jdionaldo/sc-trike/ws02/blueprint_shell/flat_P2L.png

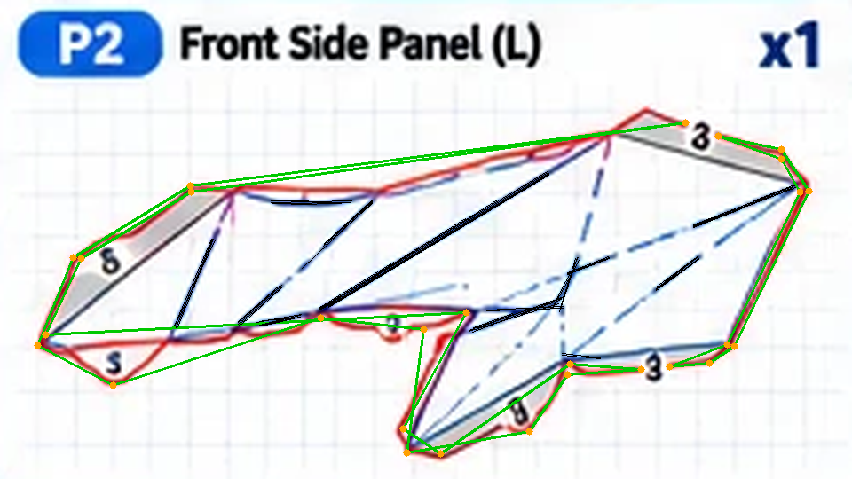
ws02/blueprint_shell/flat_P2L.png
