jdionaldo/sc-trike/ws02/blueprint_shell/flat_P8L.png

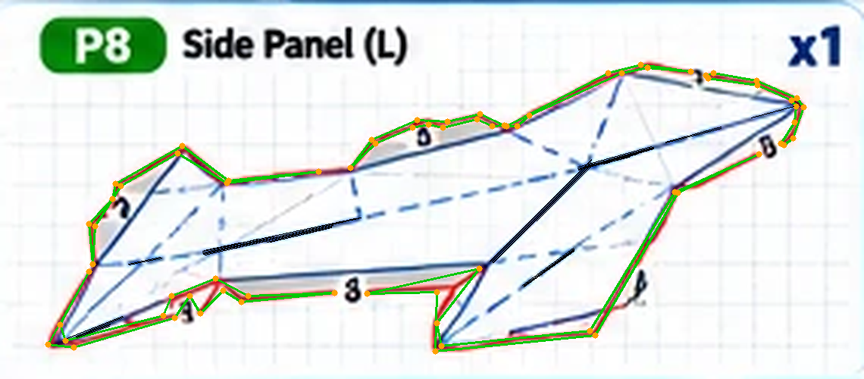
ws02/blueprint_shell/flat_P8L.png
