jdionaldo/sc-trike/ws02/WS03_REPORT.md

# WS-03 report (3WD lean-steer reverse trike)

Generated by `w3_report.py`. Mass is volume x 1.27 g/cc (solid; real prints are lighter with infill).

| part | size mm | volume cm3 | mass g |
|---|---|---|---|
| w3_arm_left | 128.0 x 31.5 x 9.5 | 17.6 | 22 |
| w3_arm_cover_left | 128.0 x 19.0 x 1.5 | 3.6 | 5 |
| w3_uplink_left | 114.0 x 10.0 x 3.5 | 3.9 | 5 |
| w3_carrier_left | 20.0 x 52.0 x 32.0 | 10.6 | 14 |
| w3_knuckle_left | 22.0 x 42.5 x 26.0 | 9.5 | 12 |
| w3_arm_right | 128.0 x 31.5 x 9.5 | 17.6 | 22 |
| w3_arm_cover_right | 128.0 x 19.0 x 1.5 | 3.6 | 5 |
| w3_uplink_right | 114.0 x 10.0 x 3.5 | 3.9 | 5 |
| w3_carrier_right | 20.0 x 52.0 x 32.0 | 10.6 | 14 |
| w3_knuckle_right | 22.0 x 42.5 x 26.0 | 9.5 | 12 |
| w3_tie_rod x2 | 119.8 x 10.4 x 5.2 | 4.3 | 11 |
| w3_lean_rod x2 | 40.4 x 10.4 x 5.2 | 1.5 | 4 |
| w3_fdc_lower | 78.0 x 80.5 x 22.0 | 88.6 | 113 |
| w3_fdc_upper | 78.0 x 60.0 x 22.0 | 77.7 | 99 |
| w3_cdc_lower | 47.0 x 52.0 x 22.0 | 29.4 | 37 |
| w3_cdc_upper | 47.0 x 52.0 x 22.0 | 28.8 | 37 |
| w3_rbc_lower | 53.0 x 30.0 x 21.0 | 24.5 | 31 |
| w3_rbc_upper | 53.0 x 30.0 x 21.0 | 24.5 | 31 |
| w3_motor_plate | 45.0 x 38.0 x 4.0 | 6.4 | 8 |
| w3_rear_arm | 116.6 x 22.0 x 12.0 | 20.6 | 26 |
| w3_rear_arm_cover | 116.6 x 22.0 x 1.5 | 3.8 | 5 |
| w3_batt_tray | 66.0 x 24.0 x 16.0 | 8.4 | 11 |
| w3_esc_tray | 50.0 x 42.0 x 16.0 | 8.9 | 11 |
| w3_uplink_standoff | 8.0 x 8.0 x 6.8 | 0.3 | 0 |
| w3_body_post x2 | 7.6 x 7.6 x 50.0 | 2.0 | 5 |
| w3_wing_left | 90.0 x 44.0 x 3.0 | 8.5 | 11 |
| w3_wing_right | 90.0 x 44.0 x 3.0 | 8.5 | 11 |
| w3_skid | 47.0 x 80.0 x 3.0 | 9.4 | 12 |
| w3_deck_front | 169.0 x 66.0 x 3.0 | 31.1 | 40 |
| w3_deck_rear | 143.0 x 120.0 x 3.0 | 43.9 | 56 |
| w3_wall_left | 120.0 x 72.0 x 3.0 | 20.8 | 26 |
| w3_wall_right | 120.0 x 72.0 x 3.0 | 20.8 | 26 |
| lid3 | 55.5 x 47.5 x 17.3 | 6.7 | 8 |
| body3_left_front | 182.6 x 71.0 x 104.3 | 36.4 | 46 |
| body3_left_rear | 212.9 x 71.0 x 136.2 | 75.2 | 95 |
| body3_right_front | 182.6 x 71.0 x 104.3 | 36.4 | 46 |
| body3_right_rear | 212.9 x 71.0 x 136.2 | 76.8 | 98 |

Printed total (solid, one set; left/right pairs listed separately): about 1019 g.

## Design numbers

- Front track 269 mm (wheel centres), wheelbase 360 mm, front tires 83 x 24, rear 112 x 62.
- Lean limit 25 deg, arm length 100 mm, arm swing about 40 deg, steering +-17 deg (radio mix), 4 servos (lean and steer per front wheel).
- Chassis raked 4 deg nose-down; shaft line at the front axle height, y +21.
- Gearing: motor 15T to centre diff ring 45T (3:1), bevel 12T/30T (2.5:1) at both ends, front belt 20T to 16T, rear belt 20T to 22T.
- Pose sweep: lean -25..+25 with steer 0, +17, -17: no interference (tests/test_w3.py).
