jdionaldo/sc-trike/ws02/WS03_CLEARANCE.md

# WS-03 clearance check

Poses: lean/steer [(0.0, 0.0), (20.0, 17.0), (-20.0, -17.0)]. Pairs closer than 0.3 mm that are not declared as mated:

- mock_cdiff_ring / w3_cring_hub: 0.00 mm
- w3_rring_hub / b_rear_ring: 0.01 mm
- battery_tray_c / b_battery: 0.01 mm
- w3_motor_plate / b_motor: 0.01 mm
- lean_mount_c / lean_horn_c: 0.01 mm
- mock_cdiff_carrier / w3_cring_hub: 0.01 mm
- w3_pillow_lower / w3_pillow_upper: 0.01 mm
- lean_mount_c / lean_ears_c: 0.01 mm
- w3_fdc_lower / w3_fdc_upper: 0.02 mm
- w3_cdc_lower / w3_cdc_upper: 0.02 mm
- w3_frame_front / w3_uplink_standoff_-1: 0.02 mm
- w3_frame_front / w3_uplink_standoff_1: 0.02 mm
- w3_rbc_lower / w3_rbc_upper: 0.02 mm
- w3_deck_rear / w3_deck_tail: 0.03 mm
- w3_deck_front / w3_frame_front: 0.04 mm
- body3_rear / body3_tail: 0.04 mm
- battery_tray_c / w3_deck_front: 0.04 mm
- w3_cring_hub / b_front_pinion_shaft: 0.05 mm
- lean_mount_c / w3_deck_front: 0.05 mm
- w3_frame_front / w3_frame_rear: 0.06 mm
- body3_front / body3_mid: 0.07 mm
- battery_tray_c / w3_frame_front: 0.07 mm
- arm_-1 / mock_fbelt_-1: 0.08 mm
- mock_bearing_x / w3_cdc_upper: 0.08 mm
- mock_bearing_ry / w3_rbc_lower: 0.08 mm
- mock_bearing_ry / w3_rbc_upper: 0.08 mm
- mock_bearing_x / w3_cdc_lower: 0.08 mm
- mock_bearing_x / w3_pillow_lower: 0.08 mm
- mock_bearing_fy / w3_fdc_upper: 0.08 mm
- mock_bearing_x / w3_rbc_lower: 0.08 mm
- mock_bearing_x / w3_fdc_upper: 0.08 mm
- mock_bearing_x / w3_fdc_lower: 0.08 mm
- mock_bearing_x / w3_pillow_upper: 0.08 mm
- mock_bearing_x / w3_rbc_upper: 0.08 mm
- w3_rring_hub / b_rear_shaft: 0.08 mm
- mock_bearing_fy / w3_fdc_lower: 0.09 mm
- w3_deck_front / w3_deck_rear: 0.09 mm
- uplink_1 / w3_uplink_standoff_1: 0.10 mm
- uplink_-1 / w3_uplink_standoff_-1: 0.10 mm
- battery_tray_c / w3_fdc_lower: 0.11 mm
- w3_deck_tail / w3_frame_rear: 0.12 mm
- w3_fdc_lower / w3_frame_front: 0.13 mm
- steer_servo_1 / w3_frame_front: 0.13 mm
- arm_-1 / pod_-1: 0.14 mm
- steer_servo_-1 / w3_frame_front: 0.15 mm
- arm_1 / pod_1: 0.15 mm
- b_lean_shock_1 / w3_fdc_upper: 0.16 mm
- w3_rbc_lower / w3_frame_rear: 0.18 mm
- body3_mid / body3_rear: 0.20 mm
- mock_bearing_x / w3_cring_hub: 0.20 mm
- w3_deck_front / w3_skid: 0.20 mm
- w3_cdc_upper / b_front_pinion_shaft: 0.20 mm
- w3_pillow_upper / b_rear_shaft: 0.20 mm
- mock_xover_pin_Pa / w3_cdc_upper: 0.20 mm
- w3_pillow_lower / b_rear_shaft: 0.20 mm
- w3_fdc_upper / b_front_pinion_shaft: 0.20 mm
- w3_fdc_lower / b_front_pinion_shaft: 0.20 mm
- w3_deck_rear / w3_frame_rear: 0.21 mm
- steer_servo_-1 / w3_deck_front: 0.21 mm
- w3_rbc_lower / b_rear_shaft: 0.21 mm
- mock_rear_axle / w3_rear_arm: 0.21 mm
- w3_rbc_upper / b_rear_shaft: 0.21 mm
- w3_cdc_lower / b_front_pinion_shaft: 0.21 mm
- w3_cdc_upper / b_rear_shaft: 0.21 mm
- mock_xover_pin_Pb / w3_cdc_upper: 0.21 mm
- w3_cdc_upper / b_motor_shaft: 0.21 mm
- w3_cdc_lower / b_rear_shaft: 0.21 mm
- w3_cdc_upper / w3_frame_rear: 0.22 mm
- arm_1 / mock_fpulley_pivot_1: 0.25 mm
- arm_1 / mock_fpulley_tip_1: 0.25 mm
- mock_rear_pulley_axle / w3_rear_arm: 0.25 mm
- arm_-1 / mock_fpulley_tip_-1: 0.25 mm
- mock_rear_pulley_pivot / w3_rear_arm: 0.25 mm
- arm_-1 / mock_fpulley_pivot_-1: 0.25 mm
- w3_cdc_lower / w3_frame_rear: 0.25 mm
- steer_servo_1 / w3_deck_front: 0.26 mm
- arm_1 / mock_fbelt_1: 0.26 mm

Pairs checked: 341. Smallest 12 clearances:

- mock_cdiff_ring / w3_cring_hub: 0.00 mm
- w3_rring_hub / b_rear_ring: 0.01 mm
- battery_tray_c / b_battery: 0.01 mm
- w3_motor_plate / b_motor: 0.01 mm
- lean_mount_c / lean_horn_c: 0.01 mm
- mock_cdiff_carrier / w3_cring_hub: 0.01 mm
- w3_pillow_lower / w3_pillow_upper: 0.01 mm
- lean_mount_c / lean_ears_c: 0.01 mm
- w3_fdc_lower / w3_fdc_upper: 0.02 mm
- w3_cdc_lower / w3_cdc_upper: 0.02 mm
- w3_frame_front / w3_uplink_standoff_-1: 0.02 mm
- w3_frame_front / w3_uplink_standoff_1: 0.02 mm

STL files that are not a single watertight body: none
