jdionaldo/sc-trike/ws02/WS03_STRENGTH.md

# WS-03 strength and robustness review

Generated by `w3_strength_report.py` from the live geometry (`w3_strength_review.py`; solver validated by `w3_strength_validate.py`, see below). Car 2.2 kg, front share 64 %.

## Loads

- static axle loads: front 13.8 N, rear 7.8 N; **3 g on one front wheel = 20.7 N** (3 x its static half-axle load; the whole front axle landing on one wheel, 41.4 N, is an abuse case); 3 g on the rear wheel 23.3 N
- 1.5 g cornering: lateral 20.7 N on the outer front wheel, 11.7 N on the rear wheel;  2 g braking: 19.0 N per front wheel, 5.2 N rear (88/12 % dynamic split)
- tyres 112 x 62 mm: contact patch 56 mm below the axle, wheel centre 134.6 mm from the centre line, i.e. about 61 mm outboard of the arm's bearing pair (18 mm apart): the vertical load makes a couple of 70 N on the two arm planes
- lean servo stall 1.8 kg.cm = 1.74 N.m; steering servo stall 12 kg.cm; rear shock force at 3 g 49 N (wheel-to-shock ratio 2.09); spring preload 10 N
- wing: 40 km/h, q = 74 Pa, plan area 194 cm2, CL 1.3 -> 1.9 N downforce, drag 0.43 N, x1.5 g; wing mass 70 g
- 1 m drop on the rear wheel: rear share 0.79 kg, 33 mm total stopping travel -> 243 N (31 g on the rear wheel); a flat drop is survived from about 0.39 m

## Material assumptions (printed PETG)

in-plane (along the print line) design stress 30 MPa; across layers 15 MPa (50 %); a tube's allowable follows its angle to the bed normal; stress concentration x1.5 at every node/notch; ultimate = 1.4 x design (drop case only); sustained loads (shock preload, weight) derated x0.4; thread pull-out 6 MPa on d x engagement; steel pins 400 MPa yield; E = 1500 MPa.

## Validation

The review FE solver was re-run on the OLD `w3_strength.py` models (old loads, old restraints, 25 MPa, no stress concentration): front arm 3.81, rear arm 4.30, frame 2.52, matching the previous 3.8 / 4.3 / 2.5 (`python w3_strength_validate.py`). The new, lower numbers therefore come from the changed inputs, not from the solver: heavier car (2.2 vs 1.6 kg), single-wheel 3 g, the wheel-offset couple that the old front-arm model left out (front arm 3 g bump: 3.9 without the couple, 3.09 with it), real pivot/lug restraints instead of a clamped root, layer-direction allowables, x1.5 concentration, and the 56 mm contact lever. Hand-check rows that did not change (tie rod 7.3) still match the old table.

## Results

| part | load case | stress MPa | allowable MPa | FS | min | verdict | print orientation |
|---|---|---|---|---|---|---|---|
| Cage frame (beam FE, motor opening cut) | 3 g bump, one front wheel (arm pivot reaction via ear plate) - worst member PS1+-FN+; deflection 0.78 mm | 2.1 | 15.3 | 7.40 | 2.0 | ok | pieces print z up: vertical and steep tubes load across layers |
| Cage frame (beam FE, motor opening cut) | 3 g bump + 1.5 g lateral (kerb strike) (arm pivot reaction via ear plate) - worst member PM+-PS1+; deflection 0.74 mm | 5.5 | 29.9 | 5.46 | 2.0 | ok | pieces print z up: vertical and steep tubes load across layers |
| Cage frame (beam FE, motor opening cut) | 1.5 g cornering (outer wheel) (arm pivot reaction via ear plate) - worst member PM+-PS1+; deflection 0.69 mm | 5.4 | 29.9 | 5.57 | 2.0 | ok | pieces print z up: vertical and steep tubes load across layers |
| Cage frame (beam FE, motor opening cut) | 2 g braking (arm pivot reaction via ear plate) - worst member PS1+-FN+; deflection 0.92 mm | 3.9 | 15.3 | 3.95 | 2.0 | ok | pieces print z up: vertical and steep tubes load across layers |
| Cage frame (beam FE, motor opening cut) | 3 g bump, rear wheel (shock tab on R2 cross tube) - worst member R3+-K2+; deflection 0.78 mm | 5.7 | 15.1 | 2.68 | 2.0 | ok | pieces print z up: vertical and steep tubes load across layers |
| Cage frame (beam FE, motor opening cut) | wing pull-off 20 N on the hood tab - worst member R1+-RW+; deflection 0.15 mm | 4.2 | 16.2 | 3.85 | 2.0 | ok | pieces print z up: vertical and steep tubes load across layers |
| Frame foot screws (M2.5 self-tapping, 3 mm of foot disc) | worst foot reaction 25 N (resultant) - thread shear 6 MPa x d x 3 mm engagement | 25.0 | 141.4 | 5.65 | 2.0 | ok | screw axis vertical |
| Rear shock upper lug plate (4.5 x 13 mm) | 3 g bump, shock force 49 N | 9.8 | 30.0 | 3.06 | 2.0 | ok | plate flat on the bed: in-plane bending, good |
| Cage frame (beam FE, motor opening cut) | skin flipped / nose impact 10 g (hinge lugs on the bumper bar) - worst member NA+-NB+; deflection 0.54 mm | 5.3 | 17.1 | 3.24 | 2.0 | ok | pieces print z up: vertical and steep tubes load across layers |
| Hinge lug plate (4.5 mm, 3.2 hole) - shear-out above the pin | skin weight/nose impact 10 g, 12 N per lug | 1.1 | 17.3 | 16.09 | 2.0 | ok | lug stands up from the cross bar: shear is in the layer plane if the frame is printed z up |
| Hinge lug plate (4.5 x 10.8 mm) - root bending | 12 N at 9 mm | 1.6 | 15.0 | 9.51 | 2.0 | ok | lug stands vertical: bending stress along z = across layers (use 15 MPa) |
| Hinge pin (3 mm steel) in double shear | 25 N | 1.7 | 240.0 | >100 | 2.0 | ok | steel |
| Hood tab magnet pad (10.4 mm, 6.3 mm pocket) | 20 N peel at 5 mm lever, stress across layers | 2.1 | 15.0 | 7.05 | 2.0 | ok | pad is vertical: across layers |
| Front arm (beam FE, 4 tubes/plane, X lattice) | 3 g bump, one front wheel - worst member L0i-L1o; tip deflection 1.2 mm; lean-rod force 86 N | 7.4 | 22.9 | 3.09 | 3.0 | ok | plates up = outer face on the bed (as now); lattice tubes across the planes are the weak direction |
| Front arm (beam FE, 4 tubes/plane, X lattice) | 3 g bump + 1.5 g lateral (kerb strike) - worst member U0i-U1i; tip deflection 0.5 mm; lean-rod force 86 N | 7.1 | 30.0 | 4.22 | 3.0 | ok | plates up = outer face on the bed (as now); lattice tubes across the planes are the weak direction |
| Front arm (beam FE, 4 tubes/plane, X lattice) | 1.5 g cornering (outer wheel) - worst member U0i-U1i; tip deflection 0.5 mm; lean-rod force 81 N | 6.5 | 30.0 | 4.60 | 3.0 | ok | plates up = outer face on the bed (as now); lattice tubes across the planes are the weak direction |
| Front arm (beam FE, 4 tubes/plane, X lattice) | 2 g braking - worst member L0i-L0o; tip deflection 0.5 mm; lean-rod force 29 N | 2.1 | 15.1 | 7.18 | 3.0 | ok | plates up = outer face on the bed (as now); lattice tubes across the planes are the weak direction |
| Front arm hub, 11 mm bearing seat (22 mm hub) | 3 g bump, radial bearing load 62 N | 3.6 | 30.0 | 8.36 | 3.0 | ok | ring in the layer plane: in-plane hoop stress, good |
| Carrier kingpin cantilever tube (R 7.5, 17 mm) | 3 g bump (bending) + 2 g braking torque - bending 1.1 MPa, torsion 1.6 MPa before KT | 4.5 | 15.0 | 3.36 | 3.0 | ok | tube axis is the bed normal now (stress across layers, 15 MPa): print the carrier on its side |
| Rear swing arm + shock hoop (beam FE, caret top rail) | 3 g bump, rear wheel - worst member 2po-B; tip deflection 1.8 mm; shock force 49 N | 9.8 | 30.0 | 3.06 | 3.0 | ok | plane normal (y) up, as now: tube axes in the layer plane except the lattice and the hoop cross tube (axis along the bed normal: weak) |
| Rear swing arm + shock hoop (beam FE, caret top rail) | 3 g bump + 1.5 g lateral - worst member 2po-B; tip deflection 1.8 mm; shock force 49 N | 9.7 | 30.0 | 3.09 | 3.0 | ok | plane normal (y) up, as now: tube axes in the layer plane except the lattice and the hoop cross tube (axis along the bed normal: weak) |
| Rear swing arm + shock hoop (beam FE, caret top rail) | 1.5 g cornering - worst member 2po-B; tip deflection 0.8 mm; shock force 21 N | 4.2 | 30.0 | 7.20 | 3.0 | ok | plane normal (y) up, as now: tube axes in the layer plane except the lattice and the hoop cross tube (axis along the bed normal: weak) |
| Rear swing arm + shock hoop (beam FE, caret top rail) | 2 g braking - worst member 2po-B; tip deflection 0.7 mm; shock force 16 N | 3.3 | 30.0 | 9.09 | 3.0 | ok | plane normal (y) up, as now: tube axes in the layer plane except the lattice and the hoop cross tube (axis along the bed normal: weak) |
| Rear swing arm + shock hoop (beam FE, caret top rail) | drive: 10 N thrust + 80 N belt - worst member 4pi-4po; tip deflection 0.4 mm; shock force 16 N | 2.2 | 15.0 | 6.90 | 3.0 | ok | plane normal (y) up, as now: tube axes in the layer plane except the lattice and the hoop cross tube (axis along the bed normal: weak) |
| Upper link (6 x 9 mm elliptical bar, 100 mm) | 2 g braking + 1.5 g cornering, 56 N compression | 55.6 | 141.3 | 2.54 | 2.0 | ok | print flat; buckling, not material, limits it |
| Kingpin 5 mm steel (cantilever from the carrier tab) | 1.5 g cornering + 2 g braking (28 N horizontal at 68 mm) | 155.7 | 400.0 | 2.57 | 2.0 | ok | steel; no print direction |
| Knuckle steering V (2 x R 3 tubes, 27 mm) | steering servo stall (98 N tie rod): 191 N axial per tube | 10.2 | 21.1 | 2.07 | 2.0 | ok | tubes run mostly along y = across the layers; print the knuckle on its side (hub axis horizontal) |
| Steering tie rod, 3 mm steel turnbuckle, 105 mm | steering servo stall, Euler buckling | 98.1 | 711.9 | 7.26 | 2.0 | ok | steel |
| Lean rocker V arm (6 mm plate, root of the arm) | lean servo stall (17.7 kg.cm, 7.4 V): 100 N at the tip | 6.3 | 30.0 | 4.73 | 2.0 | ok | plate flat on the bed (as now): loads in the layer plane, best direction |
| Lean rocker horn screws (4 x M2 at r 5.5) | servo stall, bearing in the 6 mm plate | 6.6 | 30.0 | 4.56 | 2.0 | ok | in-plane bearing |
| Servo tower plate (5 mm), ear screw bearing (2 x M2, 28 mm pitch) | lean servo stall, 62 N per screw along z | 6.5 | 15.0 | 2.30 | 2.0 | ok | plate stands vertical: z loads are ACROSS the layers; print the tower on its back (x axis up) |
| Servo tower feet (4 x M2 into the base plate, 4.5 mm engagement) | 3 g bump rod reaction 86 N pulling up - thread shear 6 MPa x d x engagement | 21.6 | 169.6 | 7.86 | 2.0 | ok | screws vertical |
| Base plate deck 6 mm (slotted, 108 mm wide) | 3 g bump: tower pulls up 86 N, diff case pushes down 66 N, 15 mm apart (40 mm effective width) | 8.2 | 30.0 | 3.66 | 2.0 | ok | deck prints flat: layers carry the bending (best), screw pull-out is across layers |
| Base plate deck 6 mm - battery + motor + servo inertia | 3 g bump, 125 g pack + 201 g motor + 55 g servo over a 100 mm span (simply supported strip, 40 mm wide) | 1.2 | 30.0 | 25.68 | 2.0 | ok | flat |
| Wing hanger (one piece, 10 mm wide web) | 1.5 g aero + handling at 40 km/h (downforce, drag, 3 g vertical, 1.5 g lateral) - worst section at z 91, area 180 mm2 (stress incl. x2 fillet factor) | 0.5 | 30.0 | 62.74 | 2.5 | ok | printed on its side (current): web plane = layer plane, best direction |
| Wing foot screw + hood boss (M2.5, one per hanger) | 1.5 g aero + handling at 40 km/h (downforce, drag, 3 g vertical, 1.5 g lateral) - screw tension 6 N vs 236 N | 5.9 | 235.6 | 39.84 | 2.5 | ok | boss is across layers: head + M2.5 flat washer (OD 6) bearing 15 MPa x 20 mm2 |
| Front arm (beam FE, 4 tubes/plane, X lattice) | landing on one wheel, whole front axle 3 g (abuse) - worst member L0i-L1o; tip deflection 2.3 mm; lean-rod force 173 N | 14.8 | 22.9 | 1.54 | 1.0 | ok | plates up = outer face on the bed (as now); lattice tubes across the planes are the weak direction |
| Rear swing arm + shock hoop (beam FE, caret top rail) | 1 m drop onto the rear wheel (rear share 0.79 kg, 243 N peak, vs ultimate) - survives a flat drop from about 0.39 m before the worst member passes ultimate | 102.2 | 42.0 | 0.41 | 1.0 | **BELOW** | plane normal (y) up |
| Cage frame (beam FE, motor opening cut) | landing on one wheel, whole front axle 3 g (abuse) (arm pivot reaction via ear plate) - worst member PS1+-FN+; deflection 1.56 mm | 4.1 | 15.3 | 3.70 | 1.0 | ok | pieces print z up: vertical and steep tubes load across layers |
| Lean rocker V arm (6 mm plate, root of the arm) | 3 g bump drives the rod (rod force): 86 N at the tip | 5.5 | 30.0 | 5.50 | 1.0 | ok | plate flat on the bed (as now): loads in the layer plane, best direction |
| Wing hanger (one piece, 10 mm wide web) | abuse: 10 N press on the blade tip - worst section at z 120, area 150 mm2 (stress incl. x2 fillet factor) | 9.5 | 30.0 | 3.15 | 1.0 | ok | printed on its side (current): web plane = layer plane, best direction |
| Wing hanger (one piece, 10 mm wide web) | abuse: 10 N side knock on the blade tip - worst section at z 91, area 180 mm2 (stress incl. x2 fillet factor) | 1.7 | 30.0 | 18.03 | 1.0 | ok | printed on its side (current): web plane = layer plane, best direction |
| Wing foot screw + hood boss (M2.5, one per hanger) | abuse: 10 N press on the blade tip - screw tension 122 N vs 236 N | 122.1 | 235.6 | 1.93 | 1.0 | ok | boss is across layers: head + M2.5 flat washer (OD 6) bearing 15 MPa x 20 mm2 |
| Wing foot screw + hood boss (M2.5, one per hanger) | abuse: 10 N side knock on the blade tip - screw tension 32 N vs 236 N | 32.3 | 235.6 | 7.29 | 1.0 | ok | boss is across layers: head + M2.5 flat washer (OD 6) bearing 15 MPa x 20 mm2 |
| Wing blade (6 mm sheet) at the hanger groove edge | 10 N press on the blade tip (core 2 mm inside the groove: 72 x 2 mm) - /3: prongs fill the groove and share the section | 10.6 | 30.0 | 2.84 | 1.0 | ok | blade printed flat: layers carry the bending |
| Wing prong screws (3 x M2.5 through the lower prong) | 10 N press on the blade tip, overturning about the groove edge (10 mm arm) - 4 mm engagement into the blade core | 33.8 | 188.5 | 5.57 | 1.0 | ok | screw axis across the blade layers |
| Rear swing arm + shock hoop (beam FE, caret top rail) | sustained: 1 g + spring preload 10 N (creep x0.4) - worst member 2po-B; shock force 26 N | 5.3 | 12.0 | 2.26 | 1.5 | ok | plane normal (y) up, as now |
| Rear shock upper lug plate (4.5 x 13 mm) | sustained spring preload + 1 g, 26 N (creep x0.4) | 5.3 | 12.0 | 2.27 | 1.5 | ok | as above |
| Cage frame (beam FE, motor opening cut) | sustained: 1 g + spring preload (shock tab) (creep x0.4) - worst member R3+-K2+ | 3.0 | 6.1 | 1.99 | 1.5 | ok | pieces print z up: vertical tubes load across layers |

## Below their minimum (1 of 49 rows)

See `WS03_STRENGTH_FIXES.md` for the geometry fixes in priority order.

- Rear swing arm + shock hoop (beam FE, caret top rail): 1 m drop onto the rear wheel (rear share 0.79 kg, 243 N peak, vs ultimate) - FS 0.41 (min 1.0)

Frame members removed from the FE because the motor can opens the hoop: .
Assumed (not in the CAD): 25% of the front arm's pivot reaction enters the cage through the servo-ear plate, the rest goes into the base plate through the housing bolts; pivot pin size 3 mm steel inferred from the 3.4 mm pad hole; skin + wing 0.25 kg. Frame feet are modelled as pinned (translations fixed).

## Decisions

- Accepted abuse case: the rear swing arm's 1 m drop onto the rear wheel (FS 0.41 against 1.0) stays a documented xfail. A 1 m drop puts about 7.8 J into the rear wheel; the shock and tyre absorb under 1 J, so no printed arm survives it. The arm is good for a flat drop of about 0.1 to 0.15 m: do not drop-test the rear. A stock progressive bump rubber on the rear shock shaft (see the BOM) softens the bottom-out.
- The ballast and small-mass numbers behind the 64.4 % front share (42 g tungsten plate, 8 g printed carrier and lid, wing and tail at 8 % infill, receiver, wires, bump rubber) are estimates: weigh the real parts and update the inventory in `w3_mass.py` before trusting the front share.
