jdionaldo/sc-trike/ws02/WS03_FIT.md

# WS-03 electronics and mechanical fit check

Envelope slid through the assembly (placeholders removed); a position counts as a fit when it touches no printed part, gear, shaft, tube or tyre.

- 3S 1300 mAh 75x35x25: 3 fitting positions; first (x, y, z): [(np.float64(-80.0), -20.0, -14.0), (np.float64(-68.0), 0.0, -6.0), (np.float64(-64.0), 0.0, -6.0)]
- 3S 2200 mAh 105x35x25: 0 fitting positions; first (x, y, z): none
- receiver 30x20x10: 102 fitting positions; first (x, y, z): [(np.float64(-200.0), -15.0, -22.0), (np.float64(-200.0), -15.0, -10.0), (np.float64(-195.0), -15.0, -22.0), (np.float64(-195.0), -15.0, -10.0)]
- Fusion SE motor 36x58 (axis x): 23 fitting positions; first (x, y, z): [(np.float64(-340.0), -21.0, 8.0), (np.float64(-340.0), -21.0, 16.0), (np.float64(-336.0), -21.0, 8.0), (np.float64(-336.0), -21.0, 16.0)]
- INJS15 servo 23x27.5x12 (axis y): 45 fitting positions; first (x, y, z): [(np.float64(-60.0), -14.0, -14.0), (np.float64(-60.0), -14.0, -6.0), (np.float64(-60.0), 0.0, -14.0), (np.float64(-60.0), 0.0, -6.0)]
