jdionaldo/sc-trike/ws02/PANELS.md

# Panel kit from refs/ref3_panels.webp (blueprint at 410 mm), scaled x0.902 to the 370 mm car

Sheet dimensions are read off the drawing; the ones marked ? are hard to read at this resolution (check before cutting).

| Panel | Sheet (mm) | At 370 mm | Notes |
|---|---|---|---|
| Overall | length 410, front track 220, height 160 | 370, 198, 144 | whole vehicle |
| 2a / C2 Front fascia and splitter | 410 wide, 220 deep, 130 and 160 tall, ?440 | 370 wide, 198 deep, 117 and 144 tall | wide splitter, two raised horns, light pockets, centre intake |
| 2b Hood / frunk | (in C2 side view) | scaled with 2a | low wedge between the horns |
| 2c / 2d / C1 Side pod and rocker | 410 long, 160 and 126 tall, 120 / 110 / 100 / 78 sections | 370, 144 and 114, 108 / 99 / 90 / 70 | diagonal, fins at the rear, swept rocker blade |
| 2e / C3 Canopy and snorkel | 310 top width, 250 base, 160 tall, side 130 and 200 long | 280, 226, 144, 117 and 180 | black glass dome, centre spine, rear snorkel box |
| 2f / 2g / C6 Fenders (pairs) | 230 wide, 180 and 160 tall, 250 and 230 long | 208, 162 and 144, 226 and 208 | rear hugger, swept tail fin |
| 2h / C4 Rear module support and diffuser | 410 wide, 70 tall, 10 | 370, 63, 9 | mesh intake, two tail horns |
| C5 Swingarm billet | 220 x 230, 11 thick | 199 x 208, 10 | triangular plate and wishbone |
| Chassis | monocoque, top and bottom halves | | separated halves in the exploded view |
