jdionaldo/sc-trike/refs/ref1_blueprint.webp

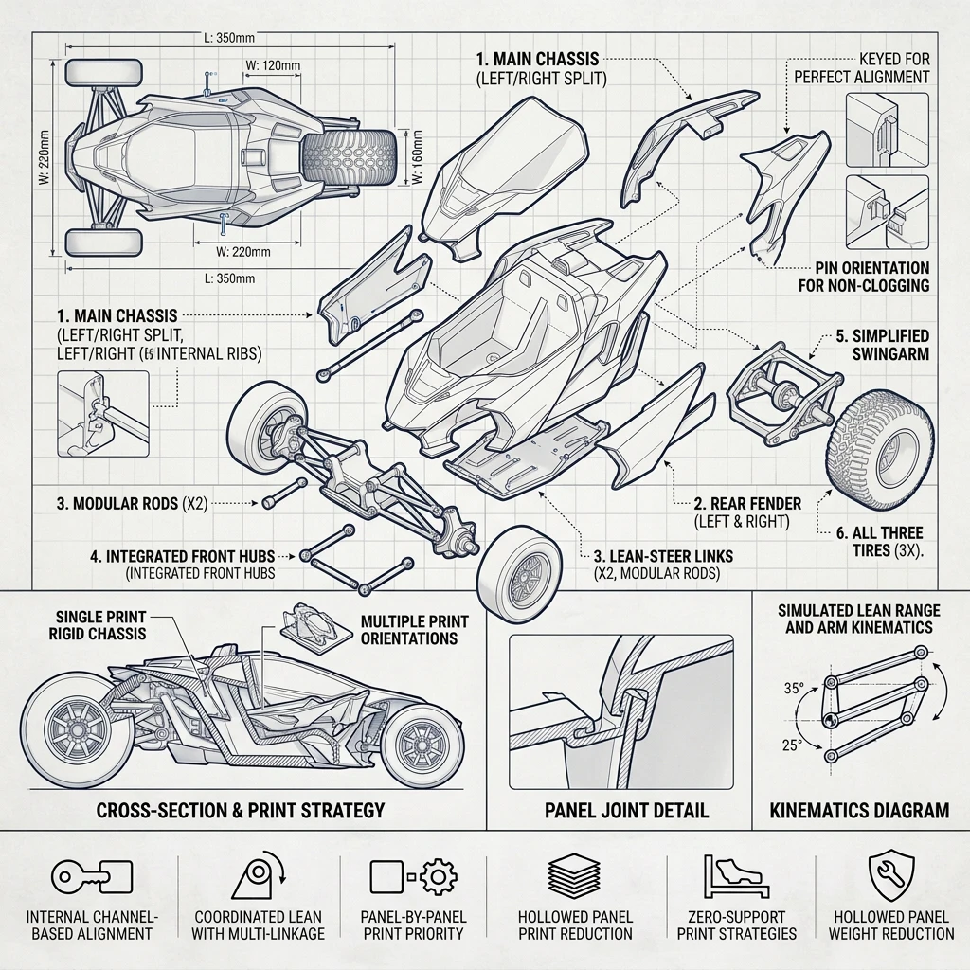
refs/ref1_blueprint.webp
