jdionaldo/sc-trike/refs/ref2_render.webp

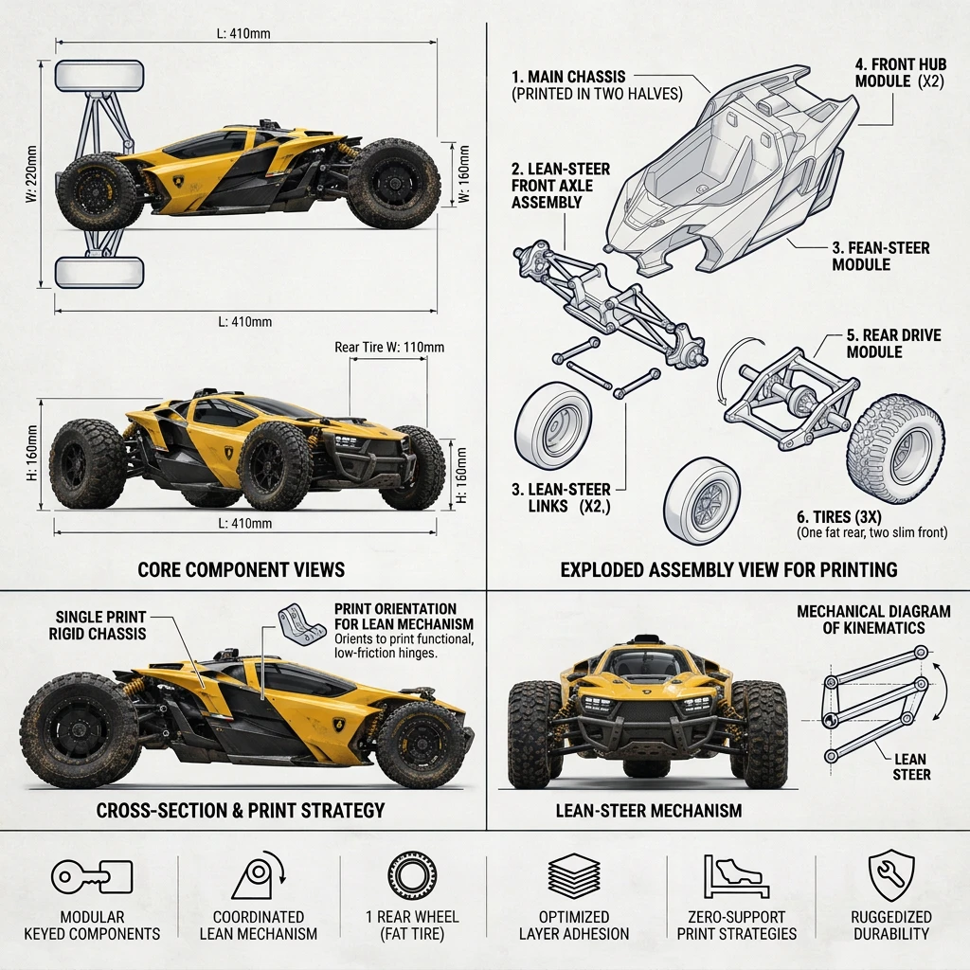
refs/ref2_render.webp
