jdionaldo/sc-trike/refs/ref3_panels.webp

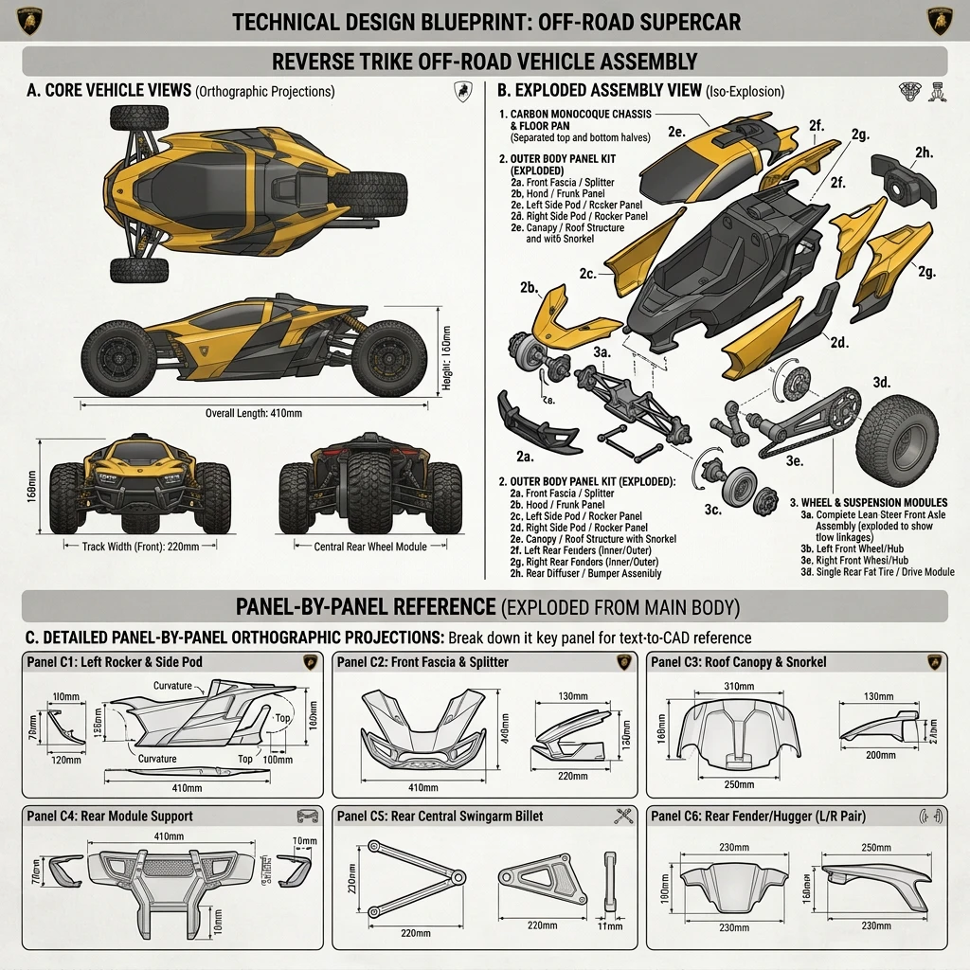
refs/ref3_panels.webp
