jdionaldo/sc-trike/refs/ref4_rt1_hammerhead.webp

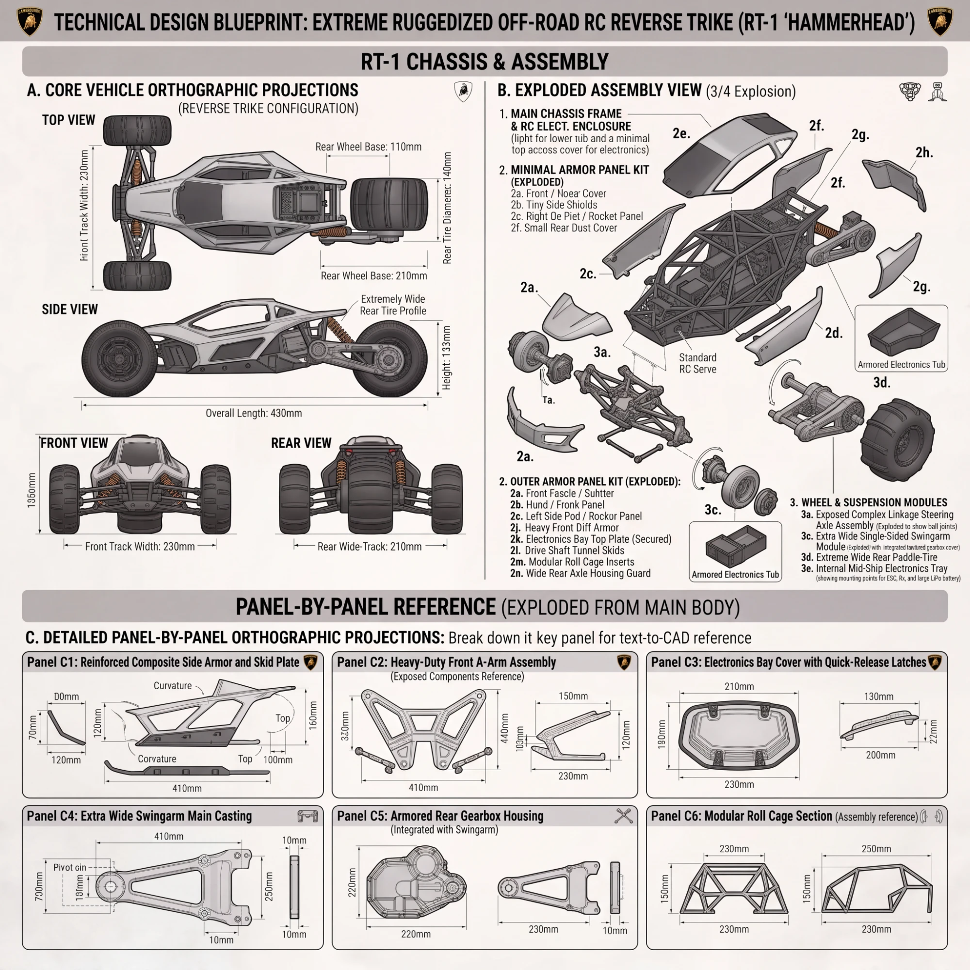
refs/ref4_rt1_hammerhead.webp
