jdionaldo/sc-trike/ws02/blueprint_shell/asm2_q34r.png

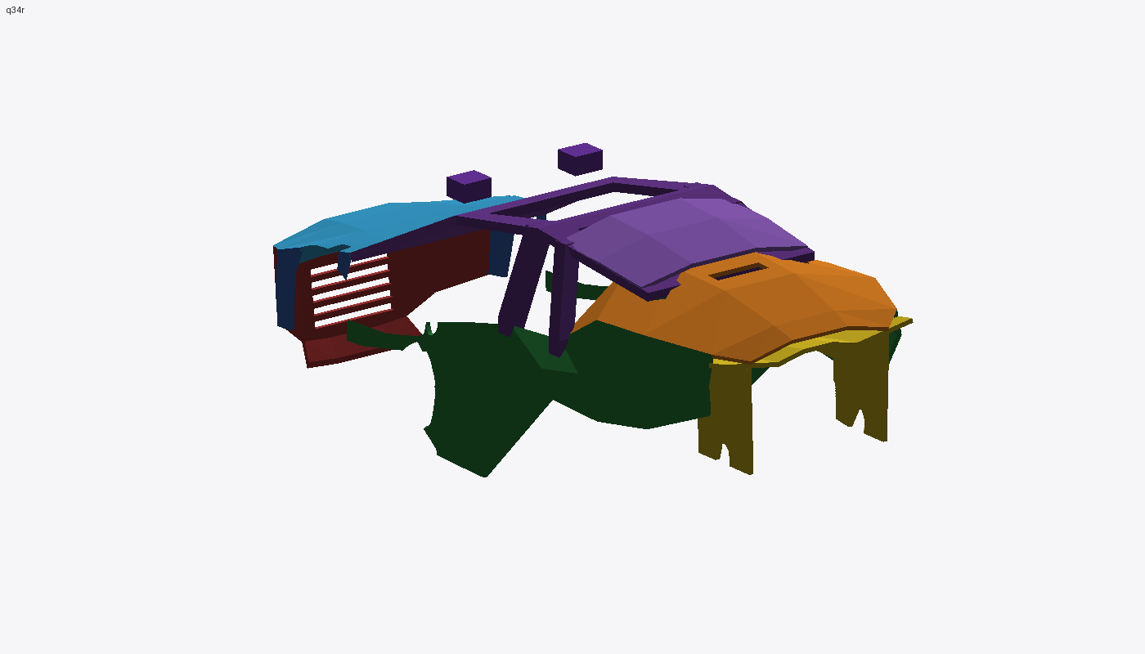
ws02/blueprint_shell/asm2_q34r.png
