jdionaldo/sc-trike/ws02/blueprint_shell/asm2_rear_low.png

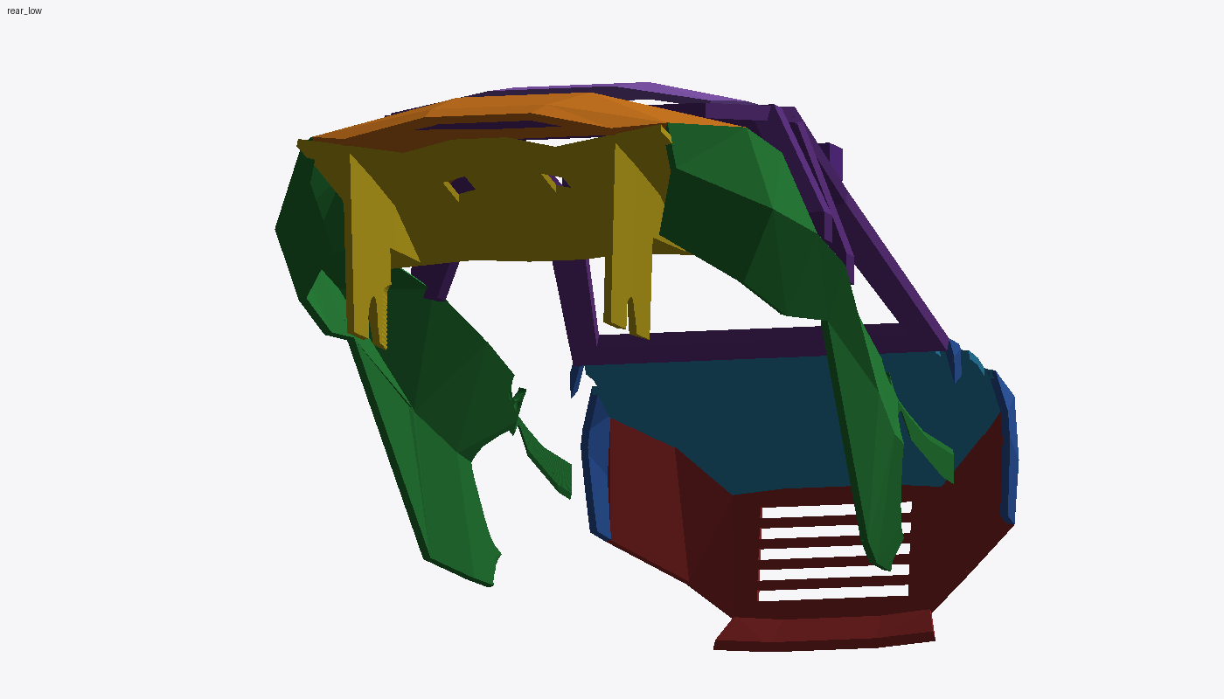
ws02/blueprint_shell/asm2_rear_low.png
