jdionaldo/sc-trike/ws02/blueprint_shell/asm_q34f.png

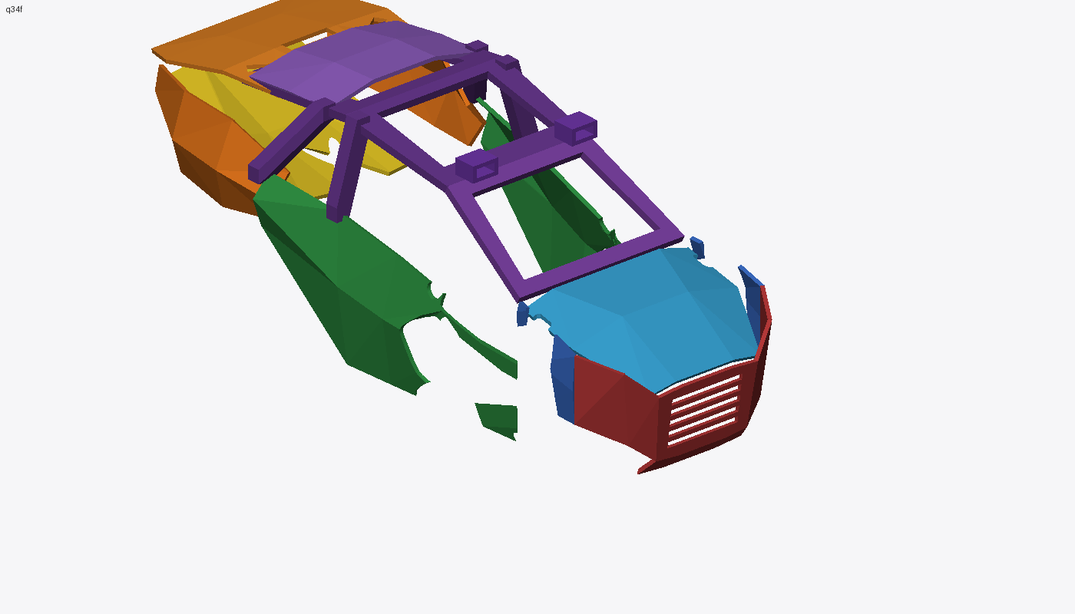
ws02/blueprint_shell/asm_q34f.png
