jdionaldo/sc-trike/ws02/blueprint_shell/asm_q34fl.png

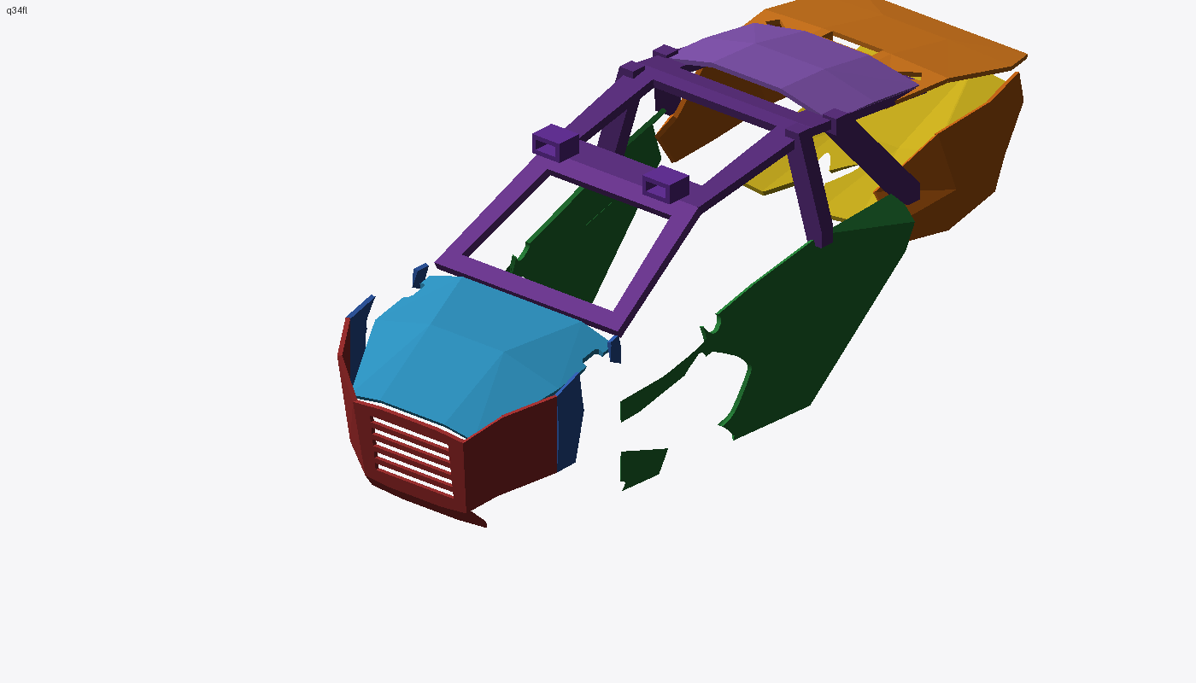
ws02/blueprint_shell/asm_q34fl.png
