jdionaldo/sc-trike/ws02/blueprint_shell/asm_q34r.png

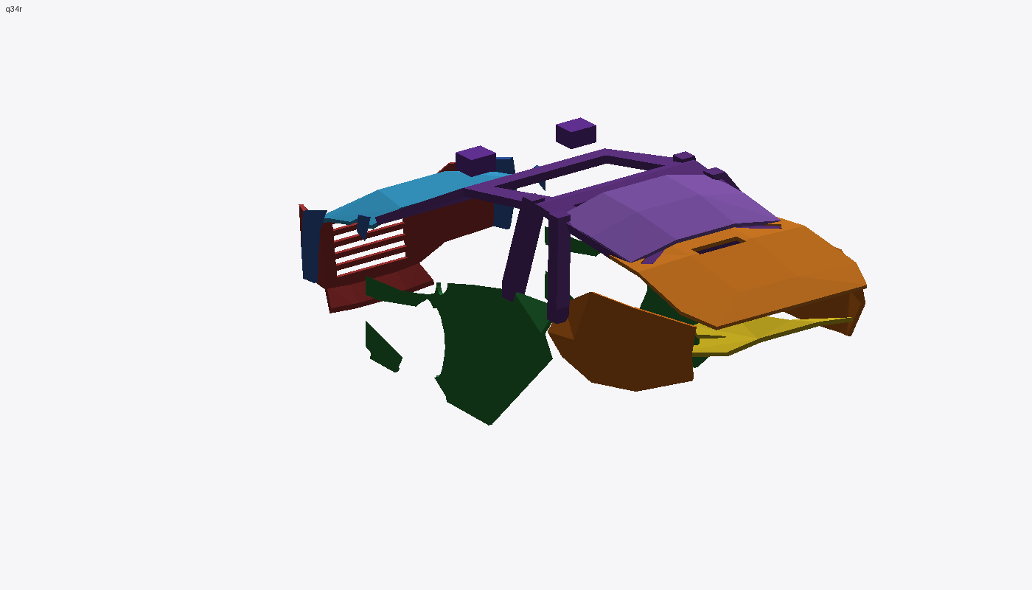
ws02/blueprint_shell/asm_q34r.png
