jdionaldo/sc-trike/ws02/blueprint_shell/flat_P1.png

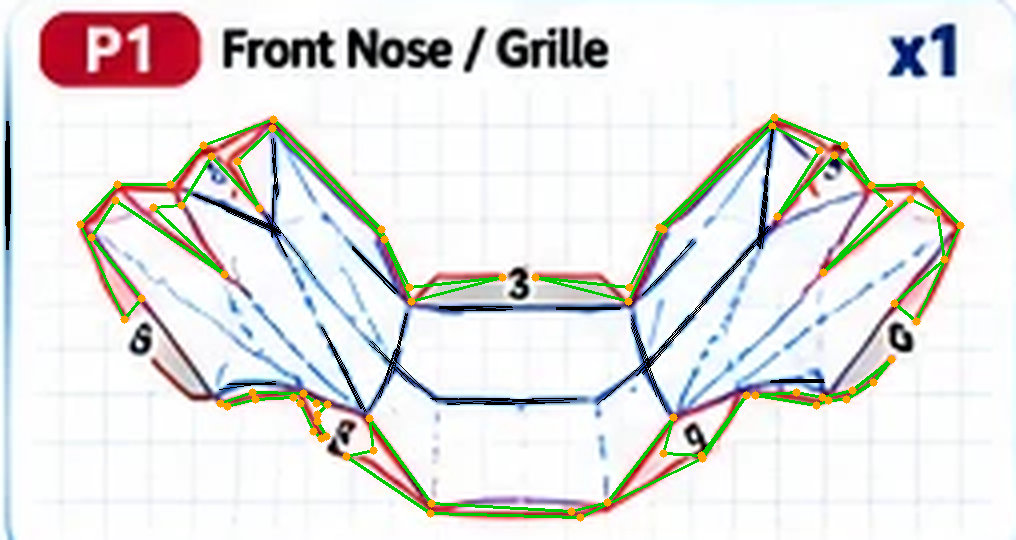
ws02/blueprint_shell/flat_P1.png
