jdionaldo/sc-trike/ws02/blueprint_shell/flat_P2R.png

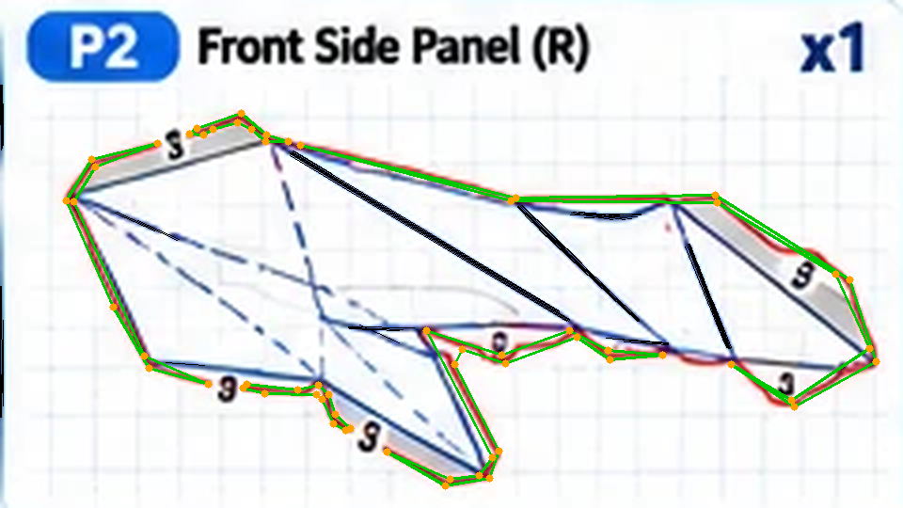
ws02/blueprint_shell/flat_P2R.png
