jdionaldo/sc-trike/ws02/blueprint_shell/flat_P3.png

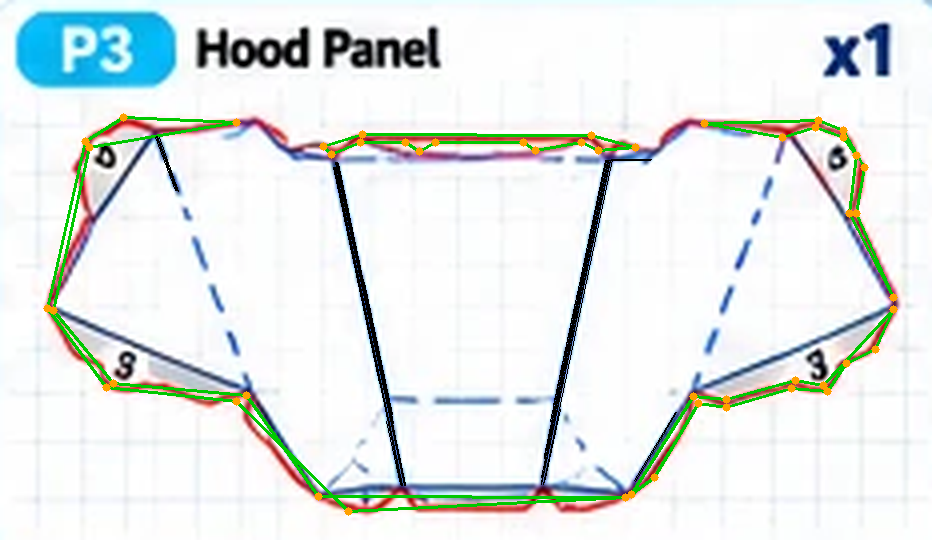
ws02/blueprint_shell/flat_P3.png
