jdionaldo/sc-trike/ws02/blueprint_shell/flat_P4.png

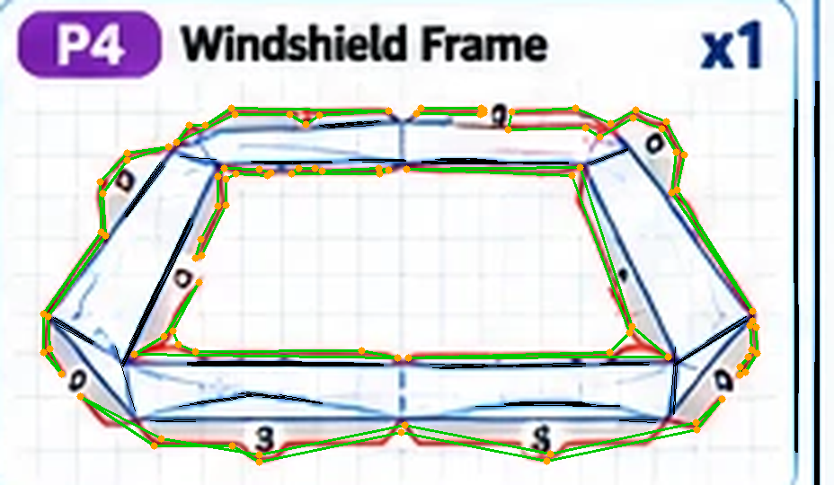
ws02/blueprint_shell/flat_P4.png
