jdionaldo/sc-trike/ws02/blueprint_shell/flat_P5.png

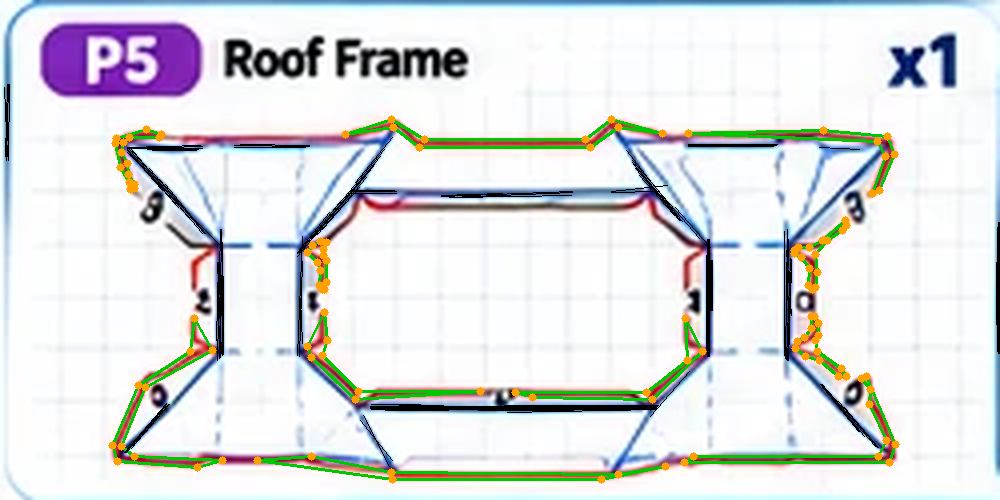
ws02/blueprint_shell/flat_P5.png
