jdionaldo/sc-trike/ws02/blueprint_shell/flat_P6.png

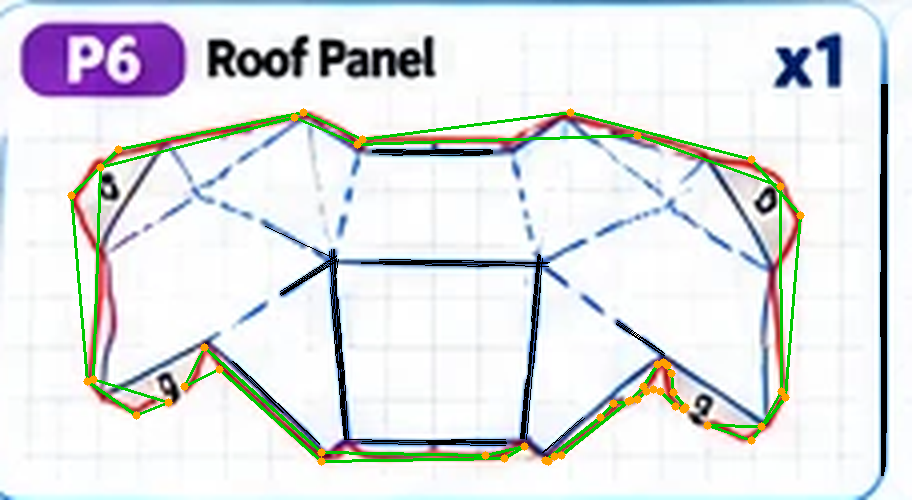
ws02/blueprint_shell/flat_P6.png
