jdionaldo/sc-trike/ws02/blueprint_shell/flat_P7.png

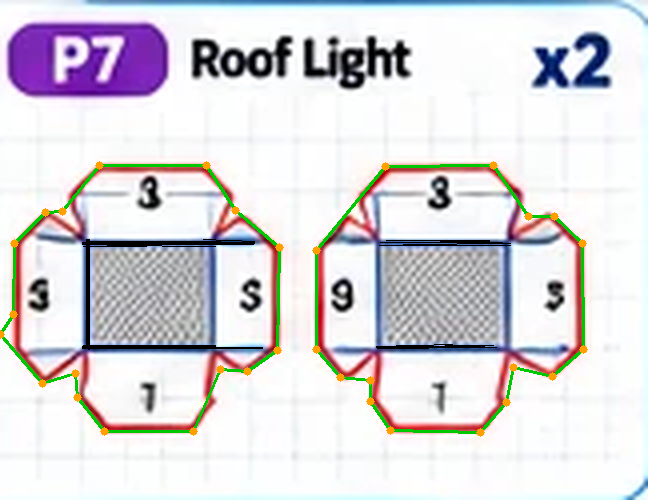
ws02/blueprint_shell/flat_P7.png
