jdionaldo/sc-trike/ws02/blueprint_shell/flat_P8R.png

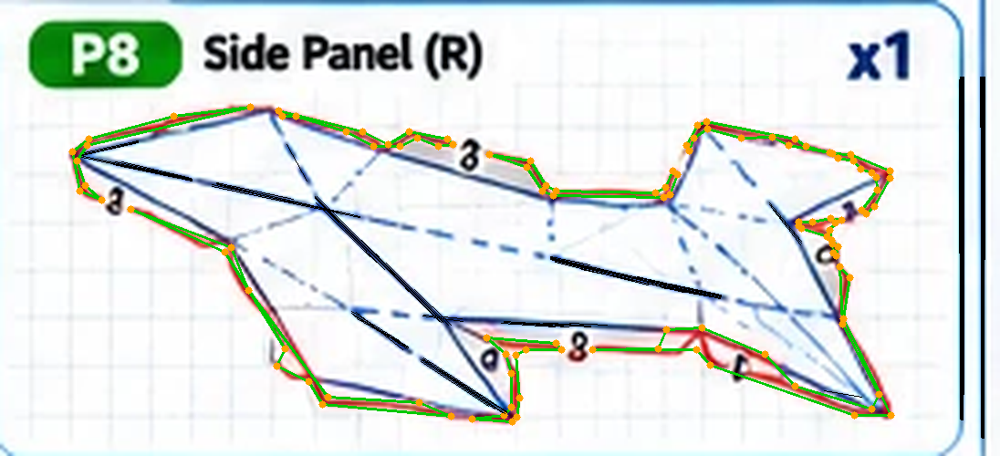
ws02/blueprint_shell/flat_P8R.png
