jdionaldo/sc-trike/ws02/blueprint_shell/flat_P9.png

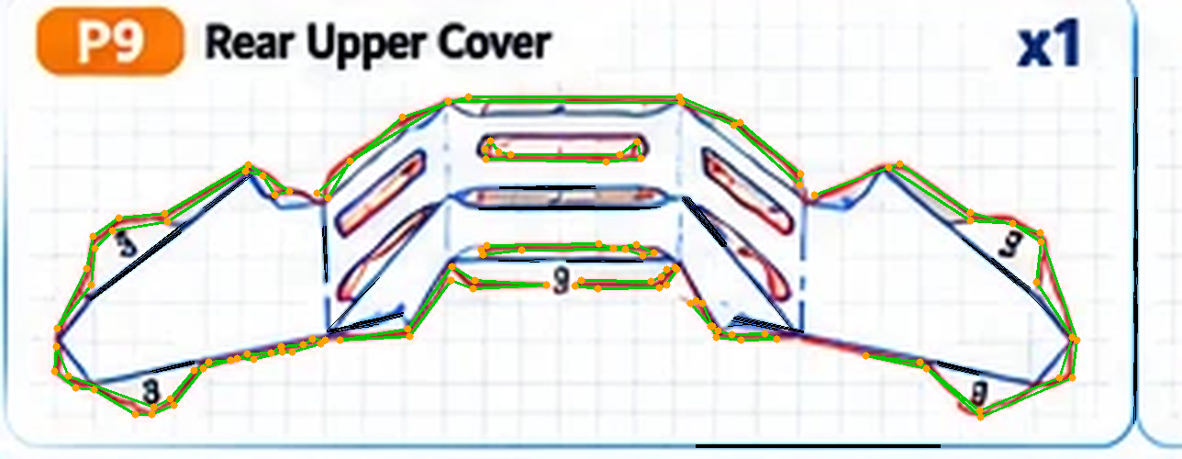
ws02/blueprint_shell/flat_P9.png
