jdionaldo/sc-trike/ws02/blueprint_shell/flat_P10L.png

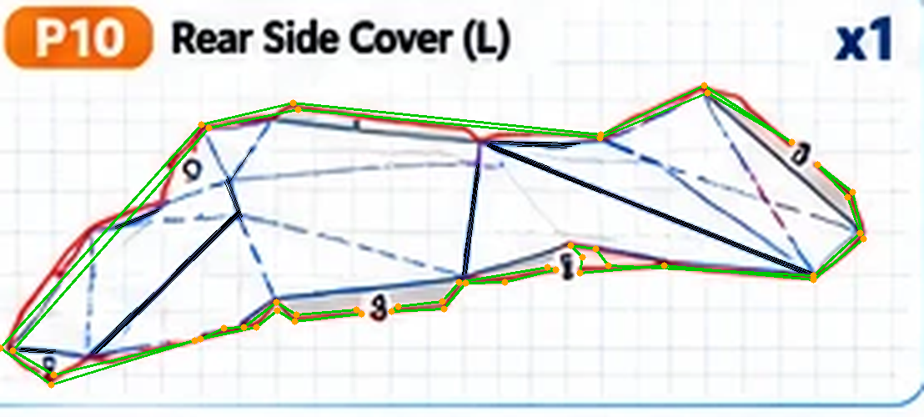
ws02/blueprint_shell/flat_P10L.png
