jdionaldo/sc-trike/ws02/blueprint_shell/flat_P10R.png

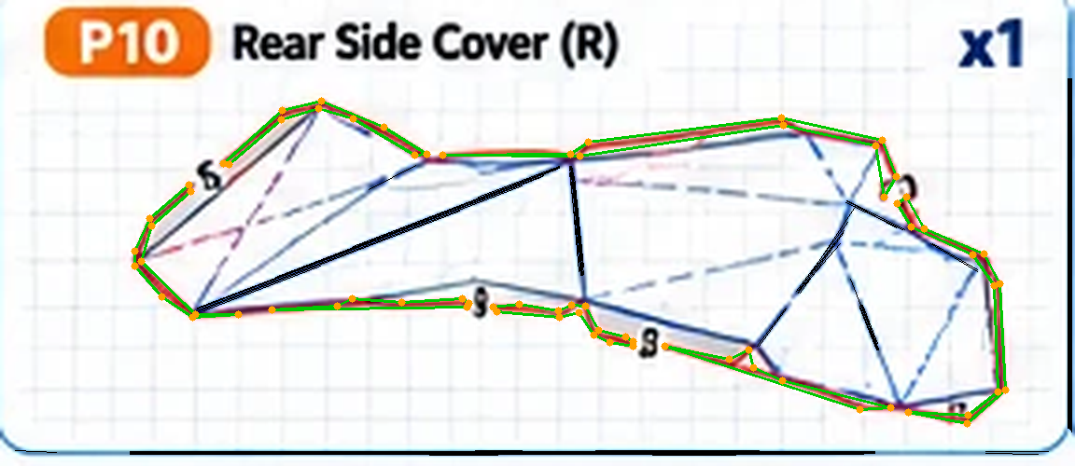
ws02/blueprint_shell/flat_P10R.png
