jdionaldo/sc-trike/ws02/blueprint_shell/flat_P11.png

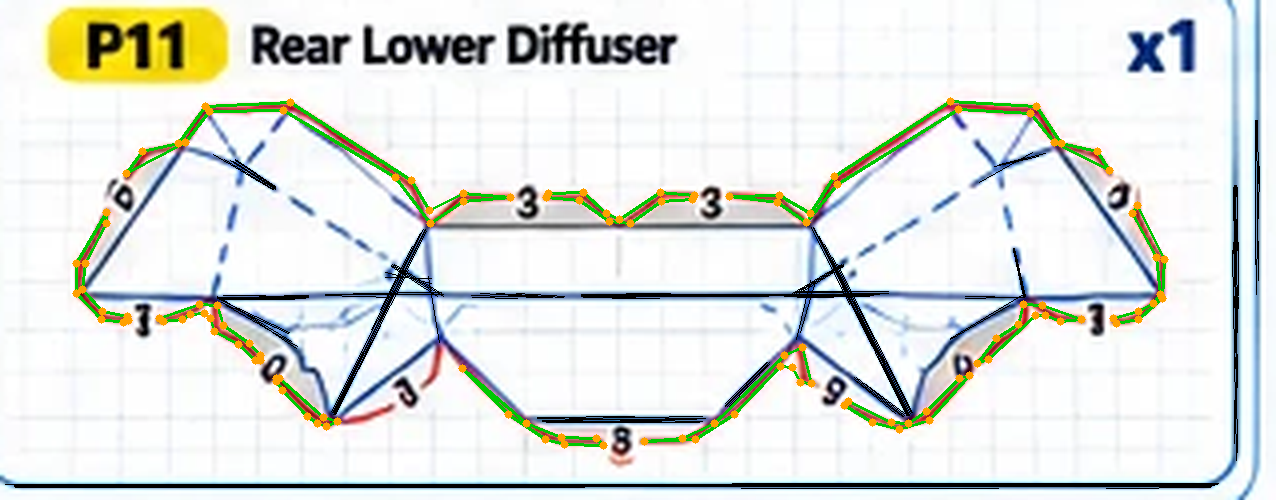
ws02/blueprint_shell/flat_P11.png
