jdionaldo/sc-trike/ws02/blueprint_shell/flat_patterns_traced.png

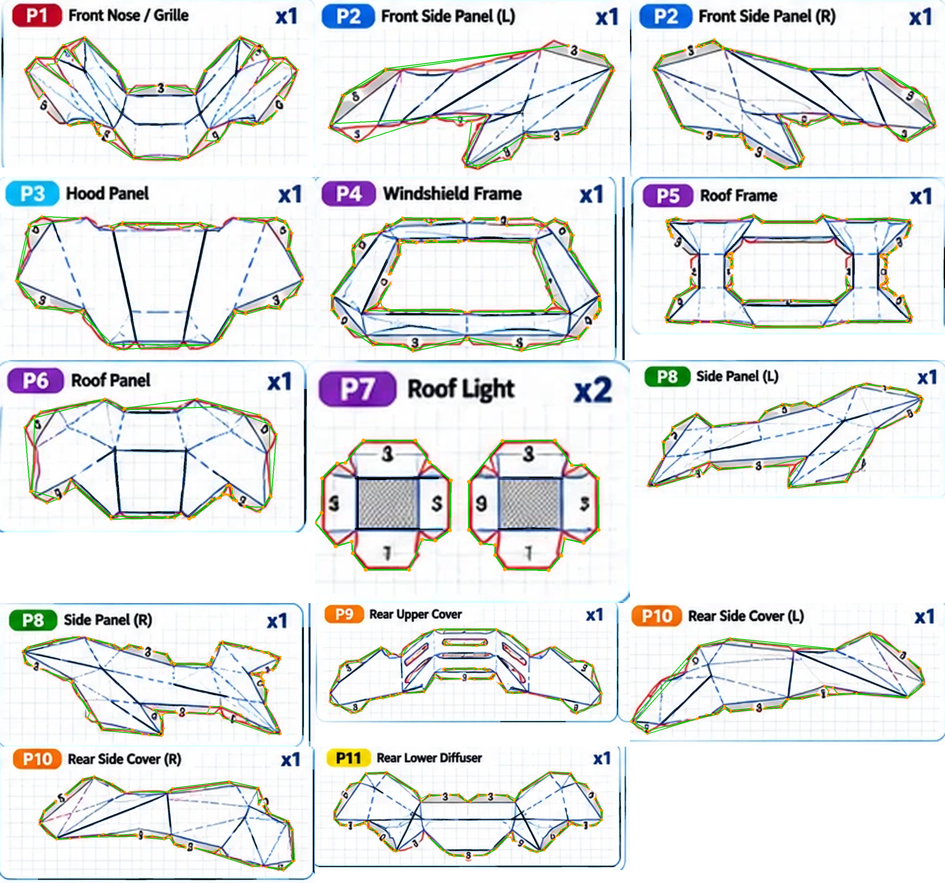
ws02/blueprint_shell/flat_patterns_traced.png
