jdionaldo/sc-trike/ws02/blueprint_shell/overlay_after_rear.png

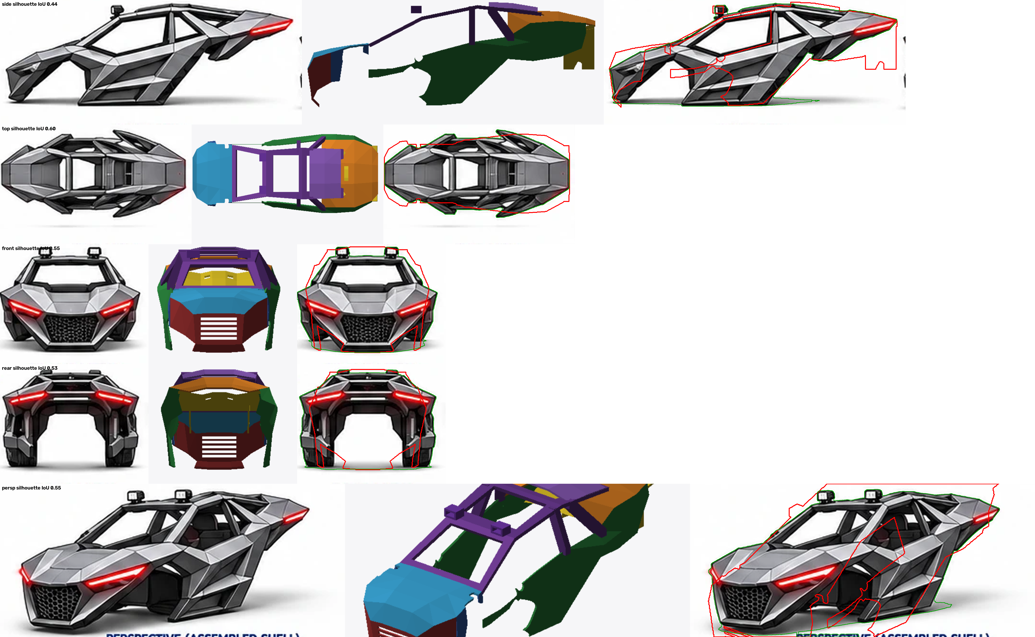
ws02/blueprint_shell/overlay_after_rear.png
