jdionaldo/sc-trike/ws02/blueprint_shell/plop_bpillar.png

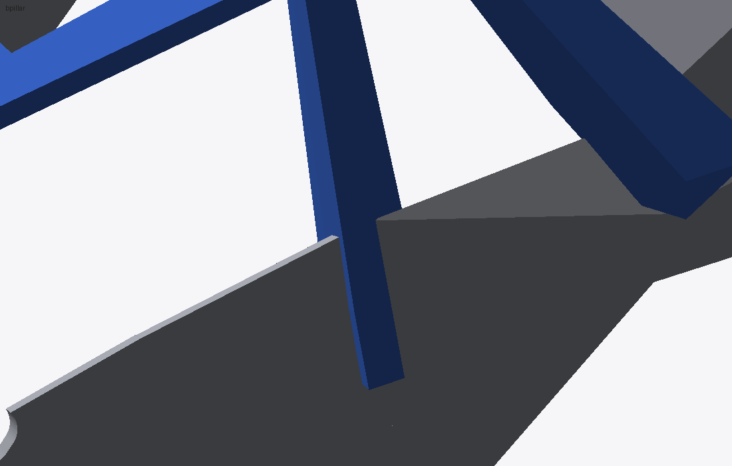
ws02/blueprint_shell/plop_bpillar.png
