jdionaldo/sc-trike/ws02/blueprint_shell/plop_rear_leg.png

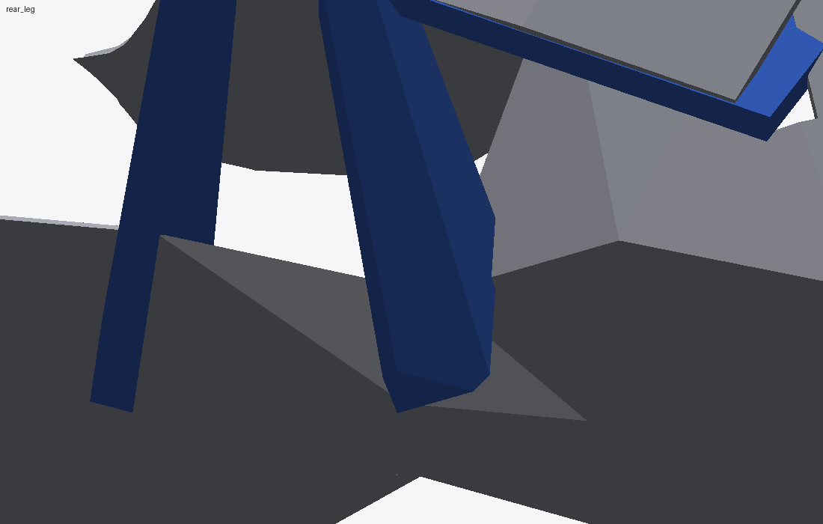
ws02/blueprint_shell/plop_rear_leg.png
