jdionaldo/sc-trike/ws02/blueprint_shell/plop_whole_rl.png

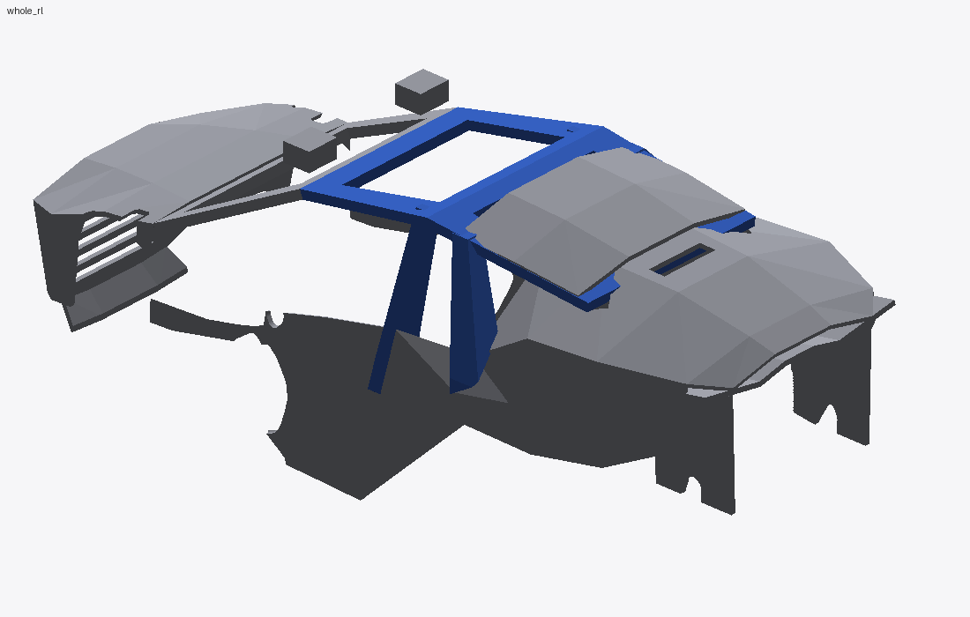
ws02/blueprint_shell/plop_whole_rl.png
