jdionaldo/sc-trike/ws02/blueprint_shell/render_final_front.png

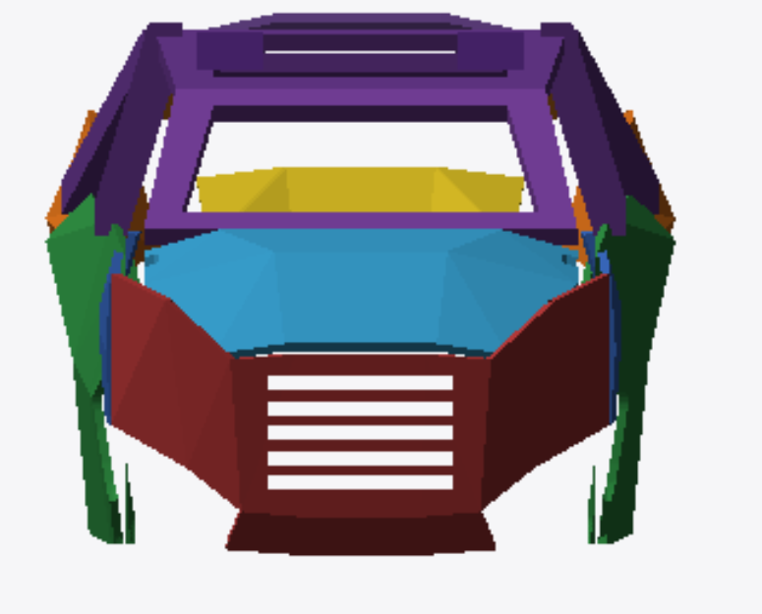
ws02/blueprint_shell/render_final_front.png
