jdionaldo/sc-trike/ws02/blueprint_shell/render_final_persp.png

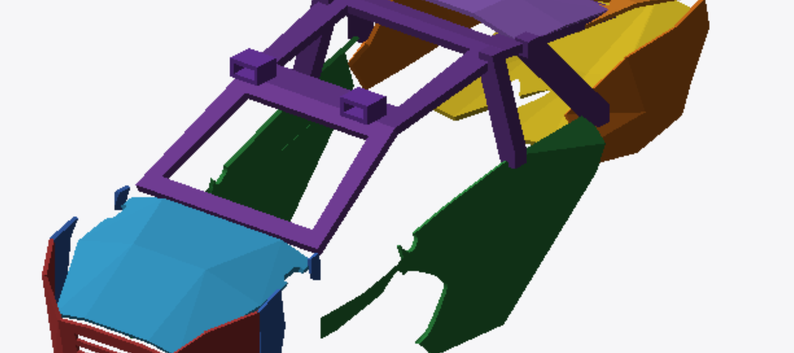
ws02/blueprint_shell/render_final_persp.png
