jdionaldo/sc-trike/ws02/blueprint_shell/render_final_rear.png

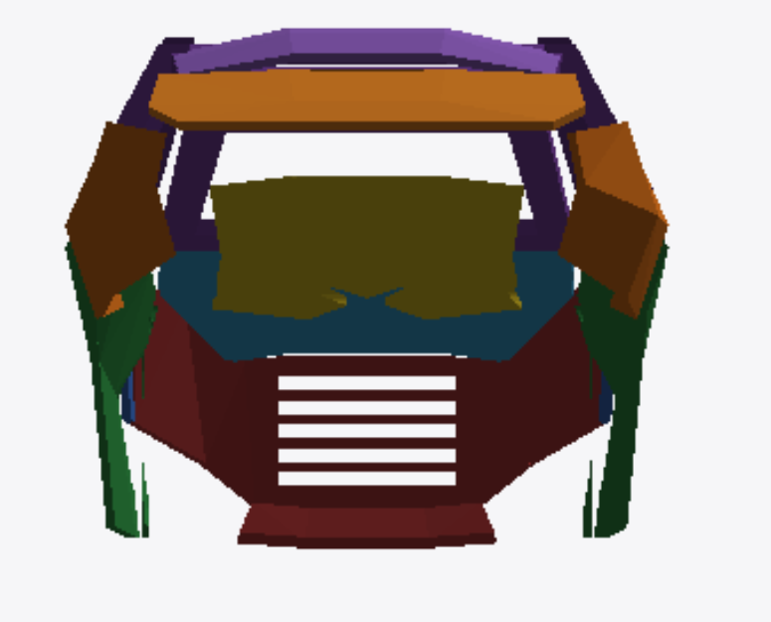
ws02/blueprint_shell/render_final_rear.png
