jdionaldo/sc-trike/ws02/blueprint_shell/render_final_side.png

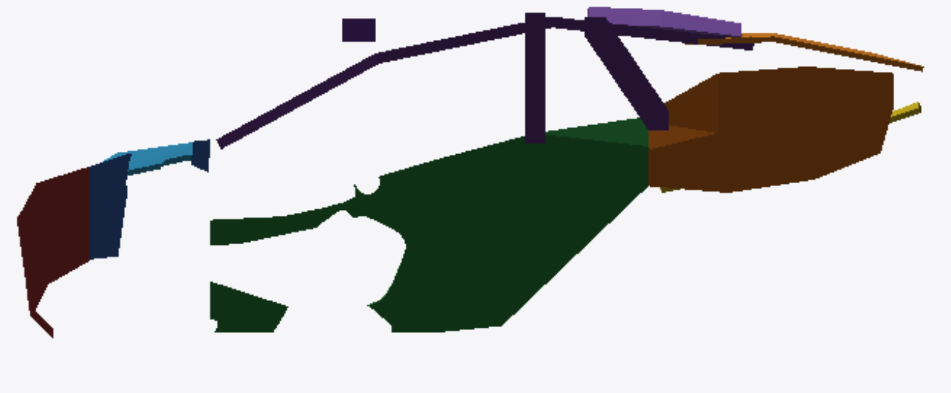
ws02/blueprint_shell/render_final_side.png
