jdionaldo/sc-trike/ws02/blueprint_shell/render_final_top.png

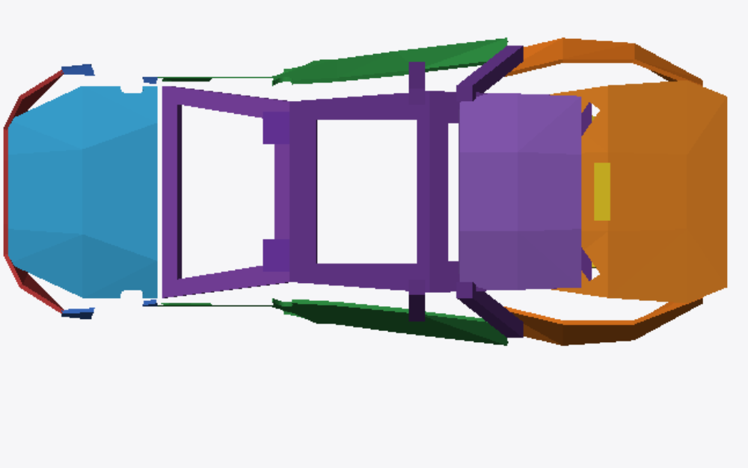
ws02/blueprint_shell/render_final_top.png
