jdionaldo/sc-trike/ws02/blueprint_shell/sect_pillars3.png

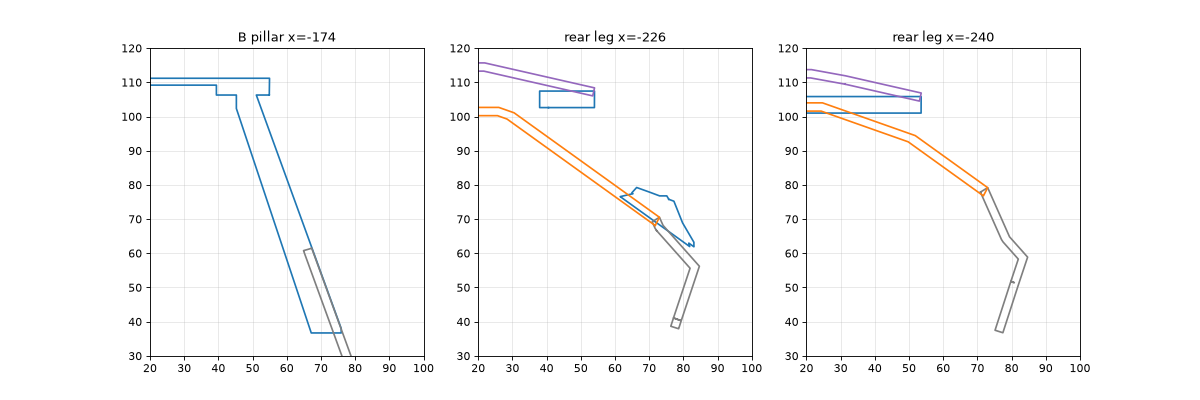
ws02/blueprint_shell/sect_pillars3.png
