jdionaldo/sc-trike/ws02/blueprint_shell/sheet71.webp

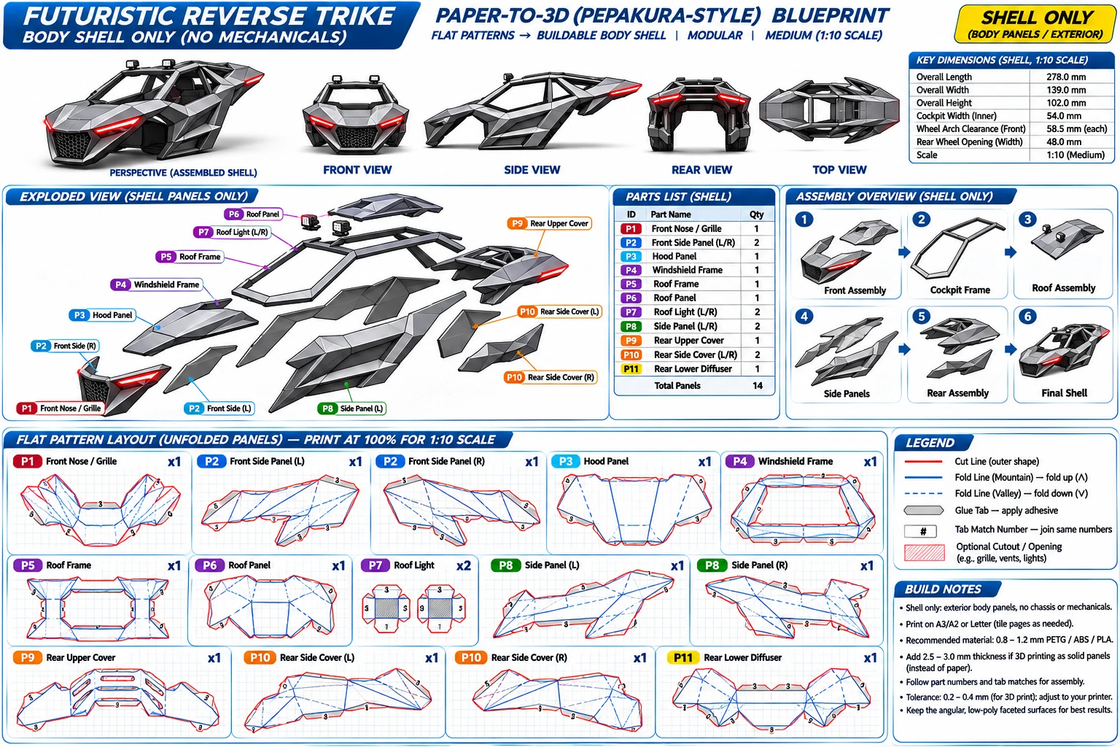
ws02/blueprint_shell/sheet71.webp
