jdionaldo/sc-trike/ws02/blueprint_shell/taper_top.png

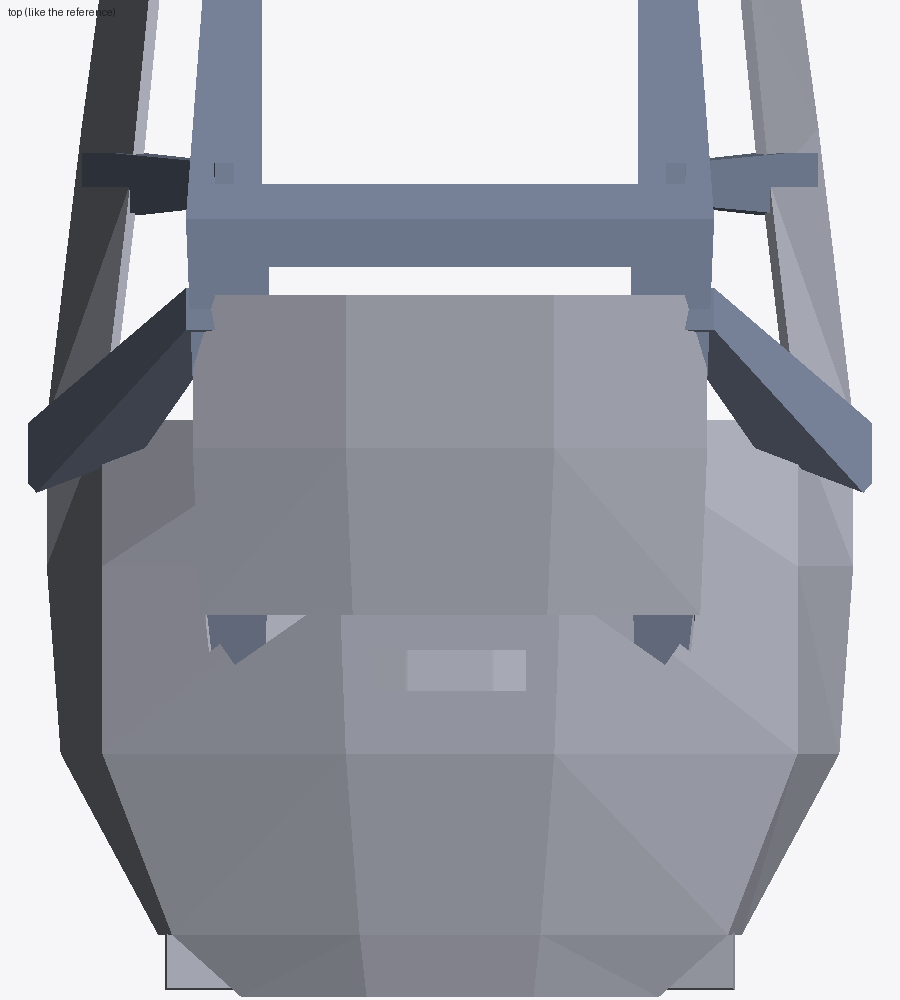
ws02/blueprint_shell/taper_top.png
