jdionaldo/sc-trike/ws02/blueprint_shell/taper_top_noP6.png

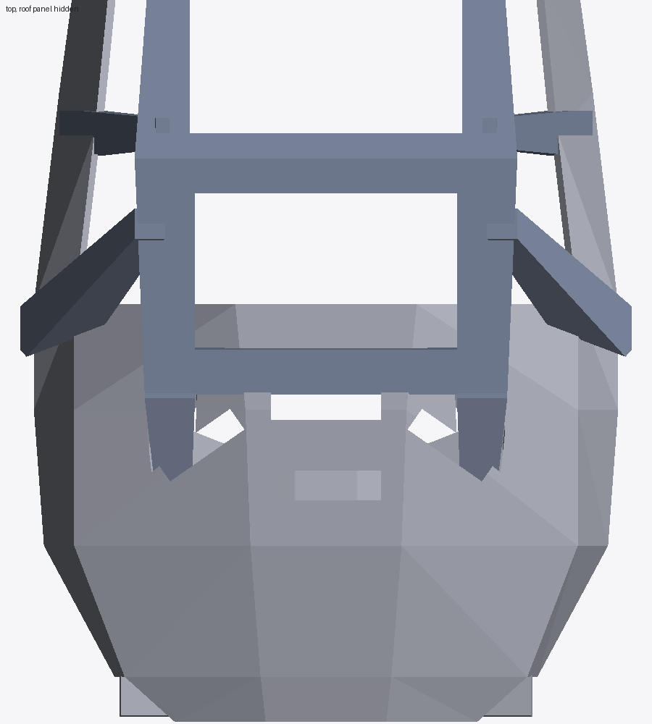
ws02/blueprint_shell/taper_top_noP6.png
