jdionaldo/sc-trike/ws02/blueprint_shell/view_expl.png

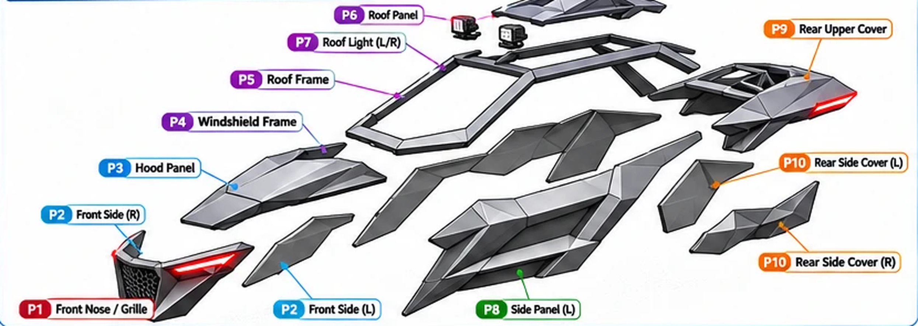
ws02/blueprint_shell/view_expl.png
