jdionaldo/sc-trike/ws02/blueprint_shell/view_front.png

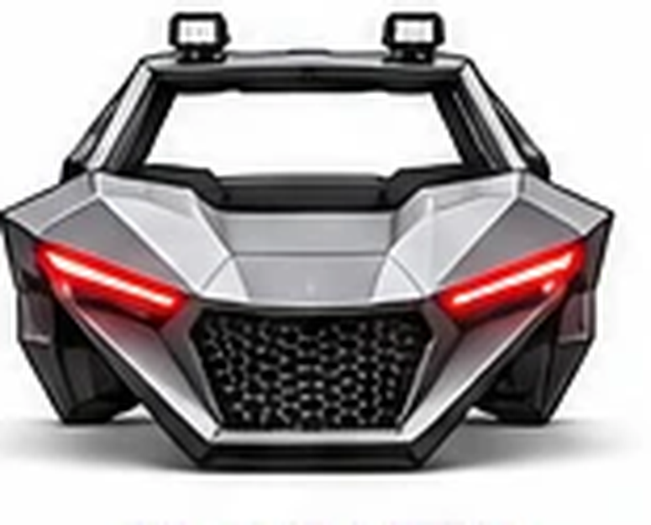
ws02/blueprint_shell/view_front.png
