jdionaldo/sc-trike/ws02/blueprint_shell/view_persp.png

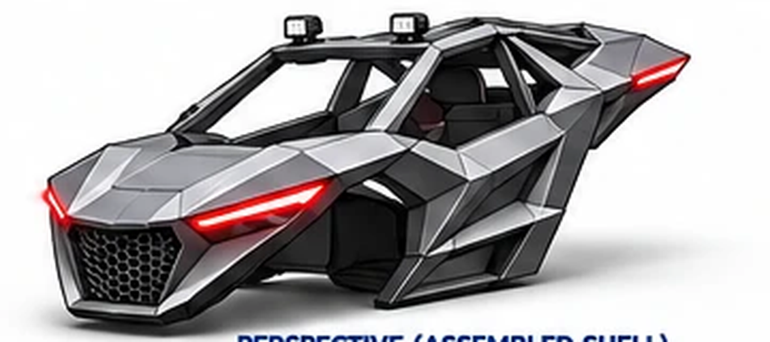
ws02/blueprint_shell/view_persp.png
