jdionaldo/sc-trike/ws02/blueprint_shell/view_rear.png

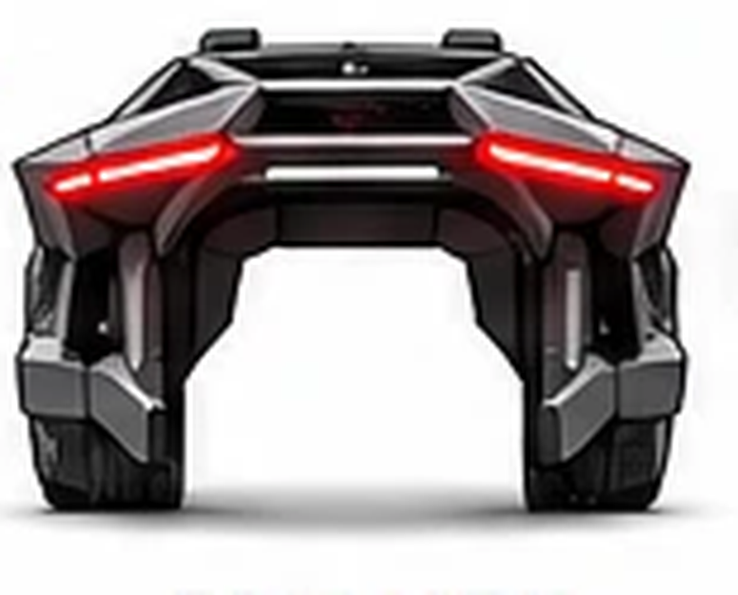
ws02/blueprint_shell/view_rear.png
