jdionaldo/sc-trike/ws02/blueprint_shell/view_side.png

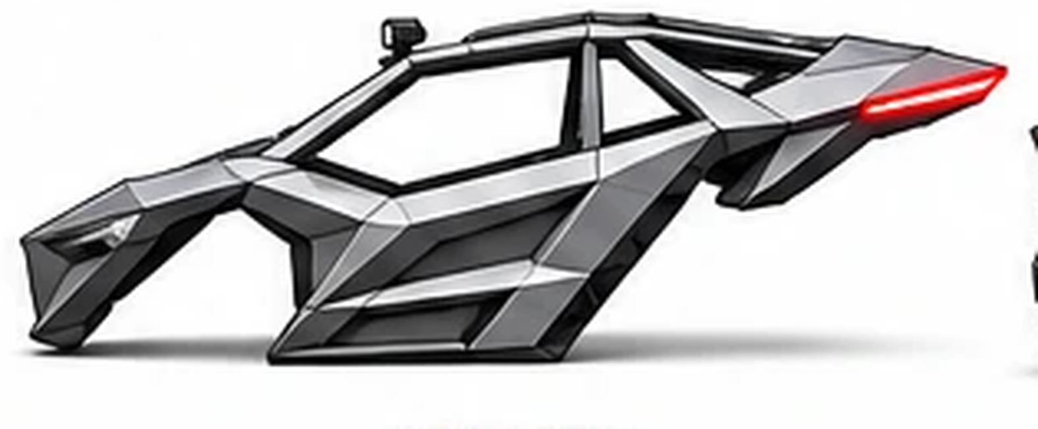
ws02/blueprint_shell/view_side.png
