jdionaldo/sc-trike/ws02/blueprint_shell/view_top.png

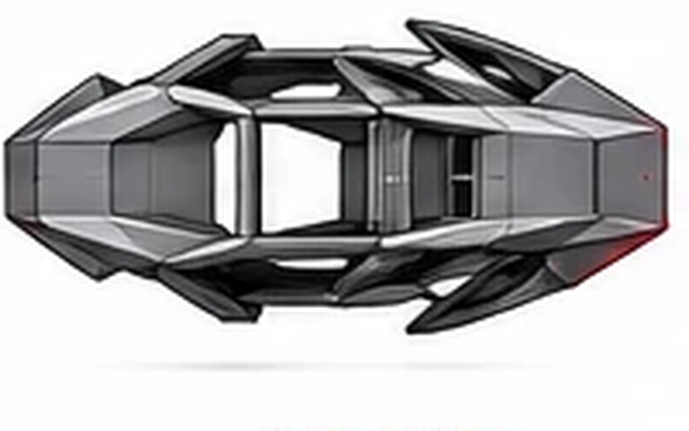
ws02/blueprint_shell/view_top.png
