jdionaldo/sc-trike/ws02/skin_fit_out/renders/mount1_nose_hinge_ears.png

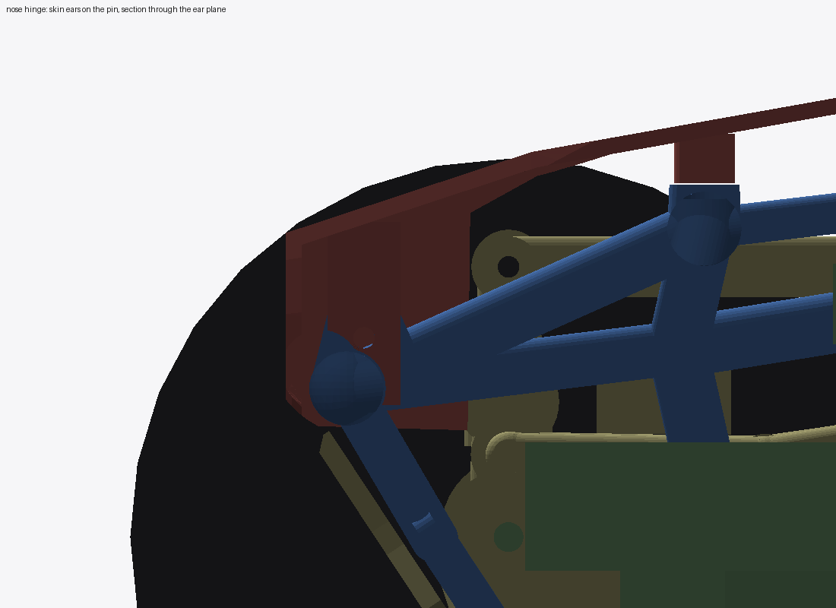
ws02/skin_fit_out/renders/mount1_nose_hinge_ears.png
