jdionaldo/sc-trike/ws02/skin_fit_out/renders/mount2_tab_nose_roof.png

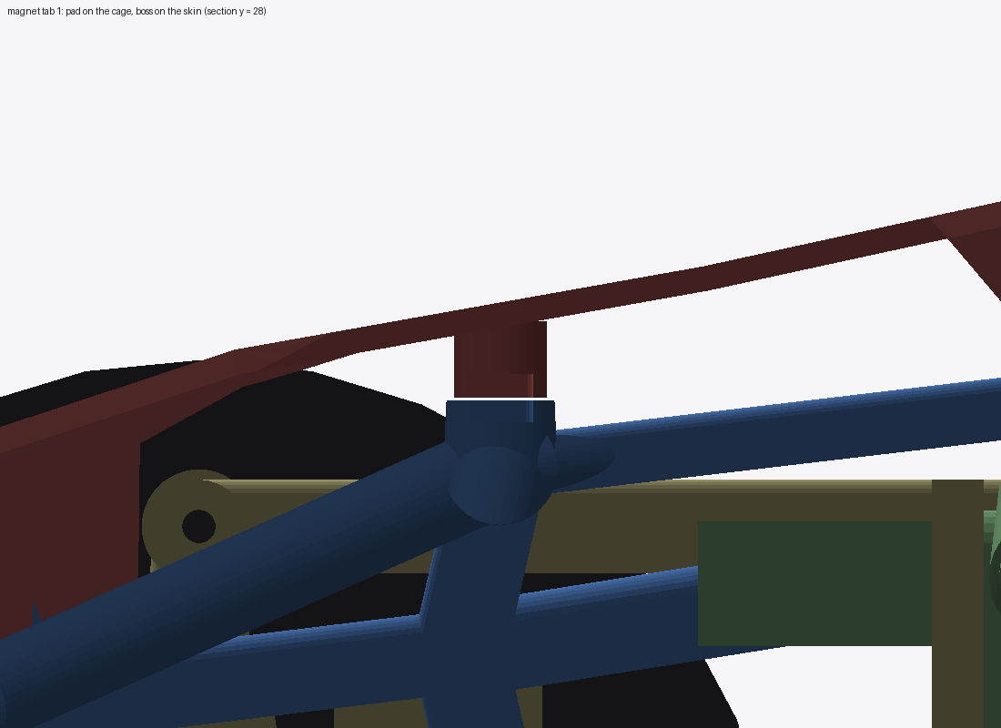
ws02/skin_fit_out/renders/mount2_tab_nose_roof.png
