jdionaldo/sc-trike/ws02/skin_fit_out/renders/mount3_tab_hoop_roof.png

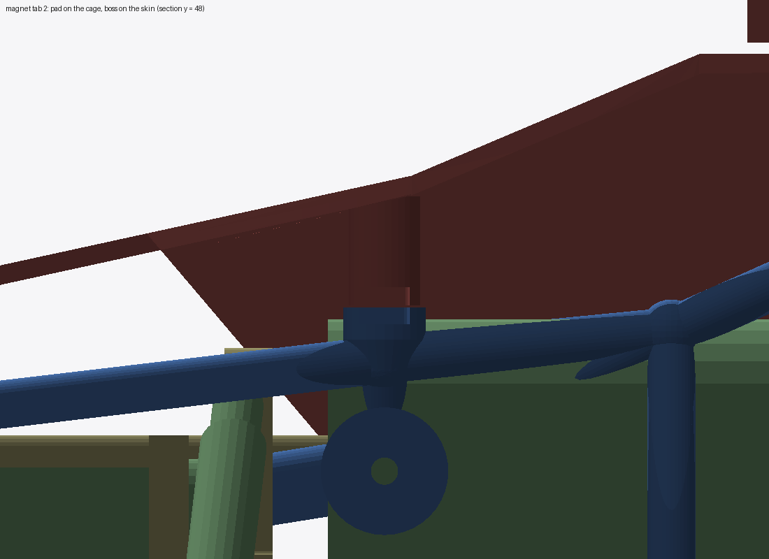
ws02/skin_fit_out/renders/mount3_tab_hoop_roof.png
