jdionaldo/sc-trike/ws02/skin_fit_out/renders/mount4_tab_cab_roof.png

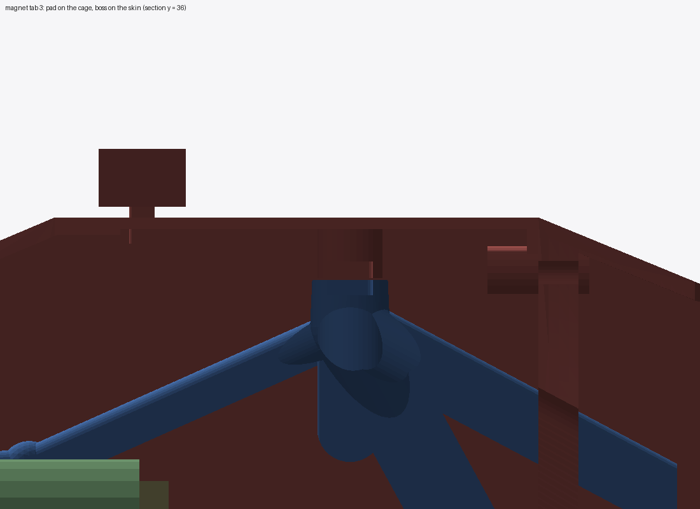
ws02/skin_fit_out/renders/mount4_tab_cab_roof.png
