jdionaldo/sc-trike/ws02/skin_fit_out/renders/mount5_tab_rear_deck.png

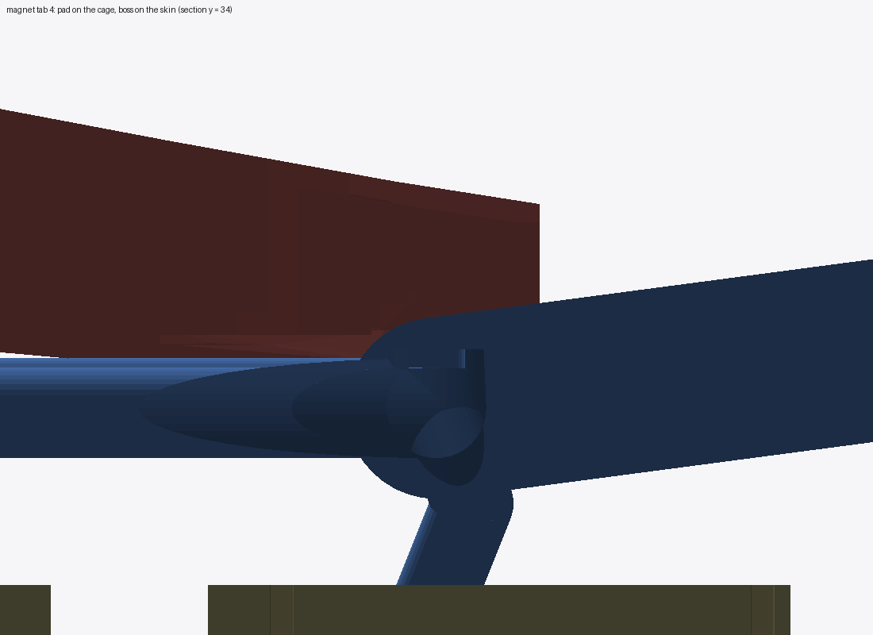
ws02/skin_fit_out/renders/mount5_tab_rear_deck.png
