jdionaldo/sc-trike/ws02/skin_fit_out/renders/mount6_joint_front_mid.png

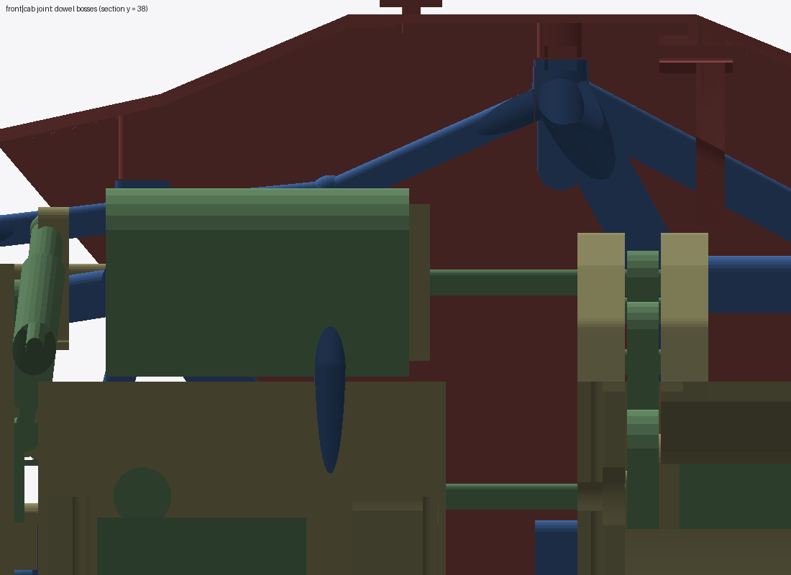
ws02/skin_fit_out/renders/mount6_joint_front_mid.png
