jdionaldo/sc-trike/ws02/skin_fit_out/renders/mount7_joint_mid_rear.png

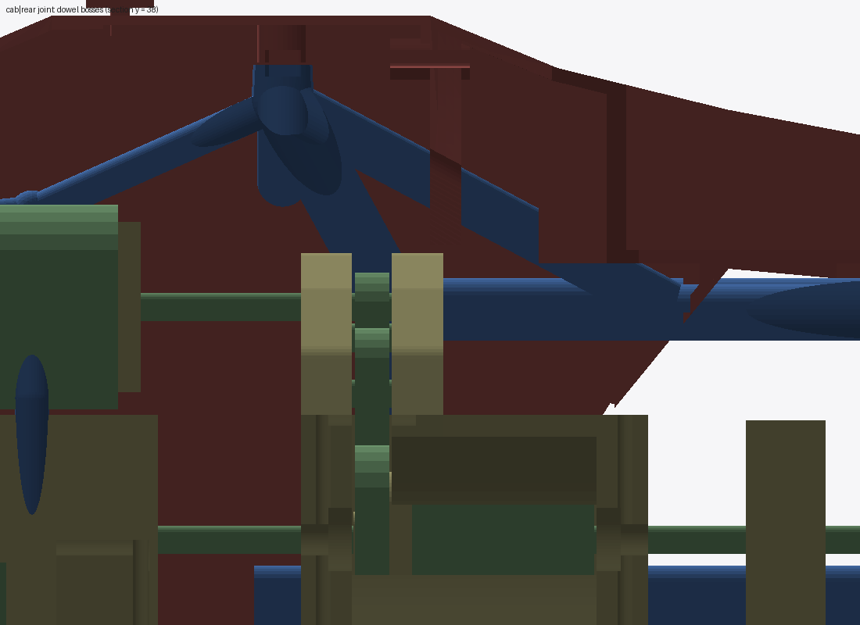
ws02/skin_fit_out/renders/mount7_joint_mid_rear.png
