jdionaldo/sc-trike/ws02/skin_fit_out/renders/mount8_front_arm_slot.png

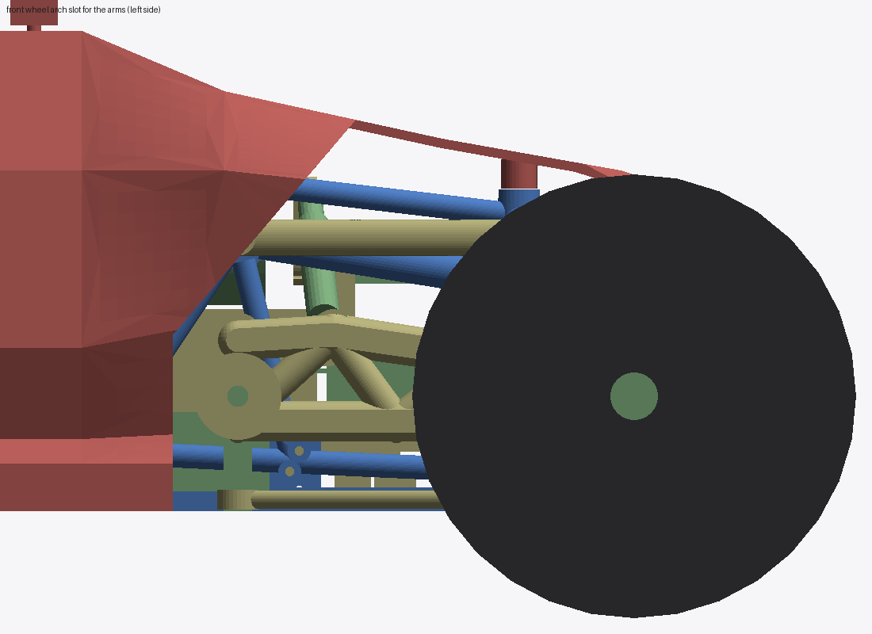
ws02/skin_fit_out/renders/mount8_front_arm_slot.png
