jdionaldo/sc-trike/ws02/skin_fit_out/renders/skirt_after_front34.png

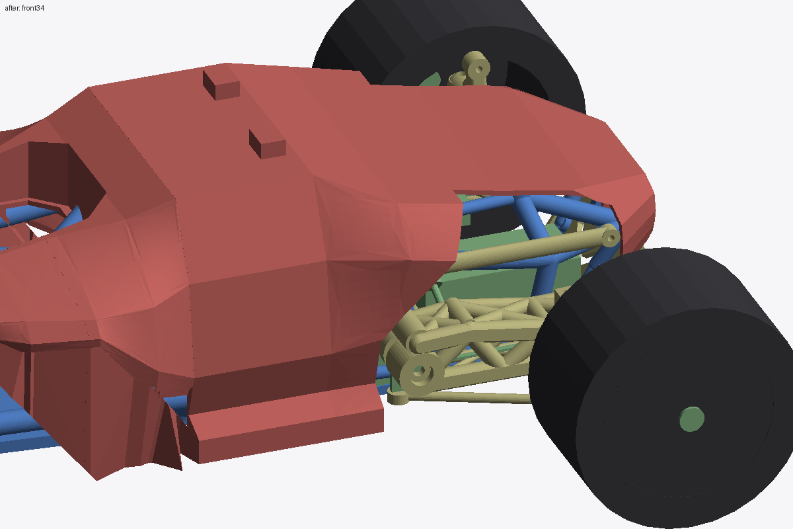
ws02/skin_fit_out/renders/skirt_after_front34.png
