jdionaldo/sc-trike/ws02/skin_fit_out/renders/skirt_after_top.png

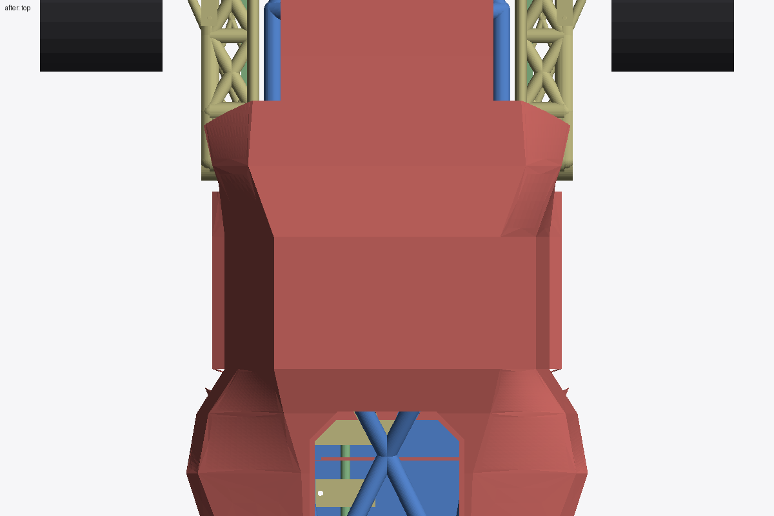
ws02/skin_fit_out/renders/skirt_after_top.png
