jdionaldo/sc-trike/ws02/skin_fit_out/renders/skirt_before_side.png

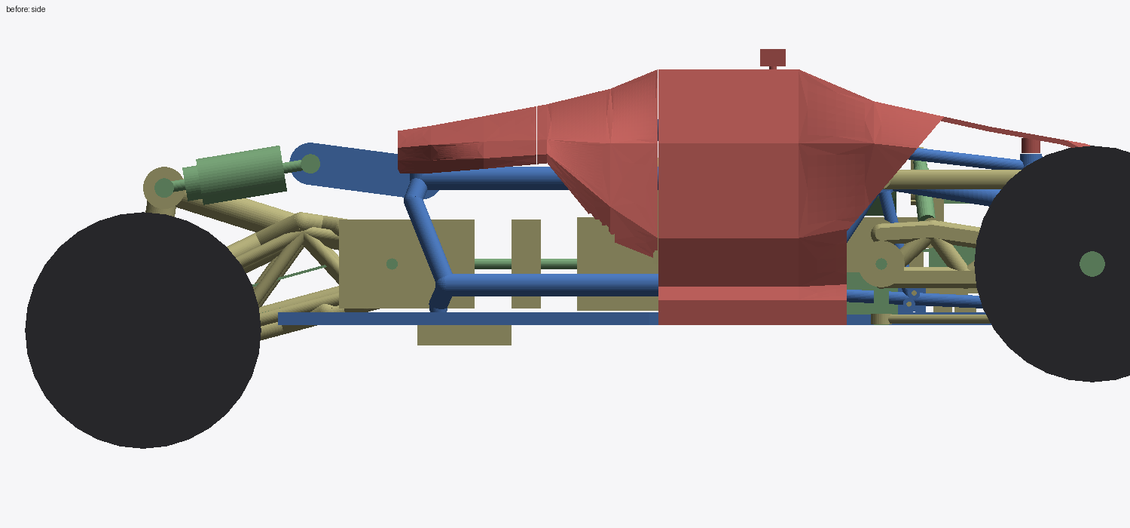
ws02/skin_fit_out/renders/skirt_before_side.png
