jdionaldo/sc-trike/ws02/skin_fit_out/renders/view1_front_left_34.png

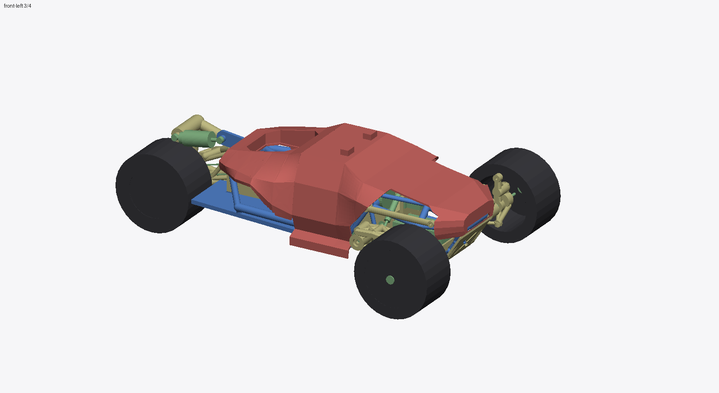
ws02/skin_fit_out/renders/view1_front_left_34.png
