jdionaldo/sc-trike/ws02/skin_fit_out/renders/view2_rear_right_34.png

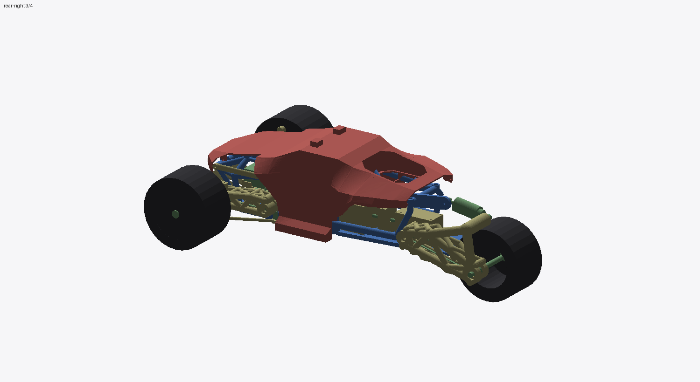
ws02/skin_fit_out/renders/view2_rear_right_34.png
