jdionaldo/sc-trike/ws02/skin_fit_out/renders/view3_side_left.png

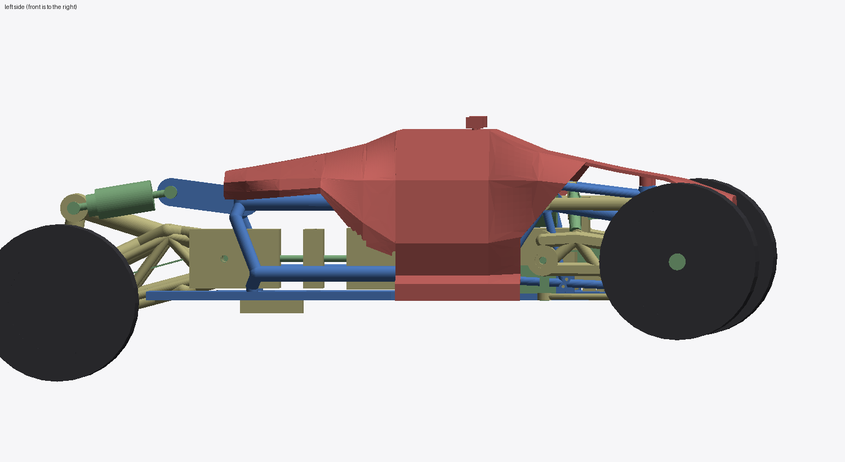
ws02/skin_fit_out/renders/view3_side_left.png
