jdionaldo/sc-trike/ws02/skin_fit_out/renders/view4_top.png

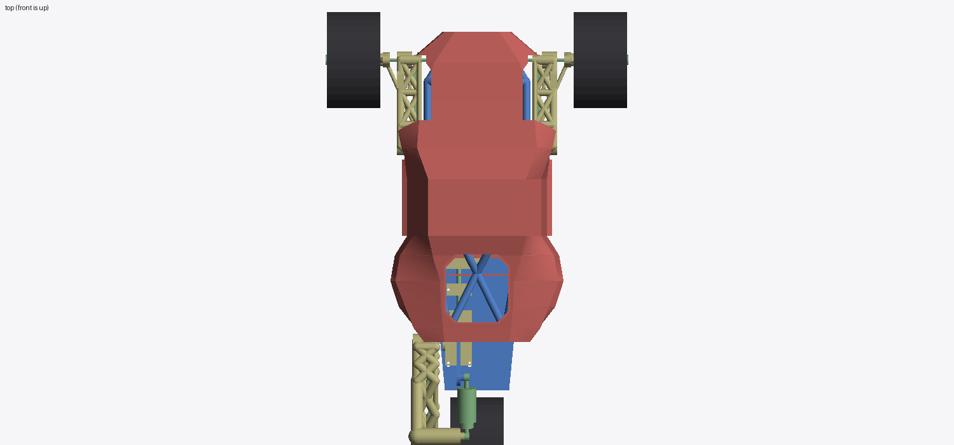
ws02/skin_fit_out/renders/view4_top.png
