jdionaldo/sc-trike/ws02/WS03_blueprint_overlay.png

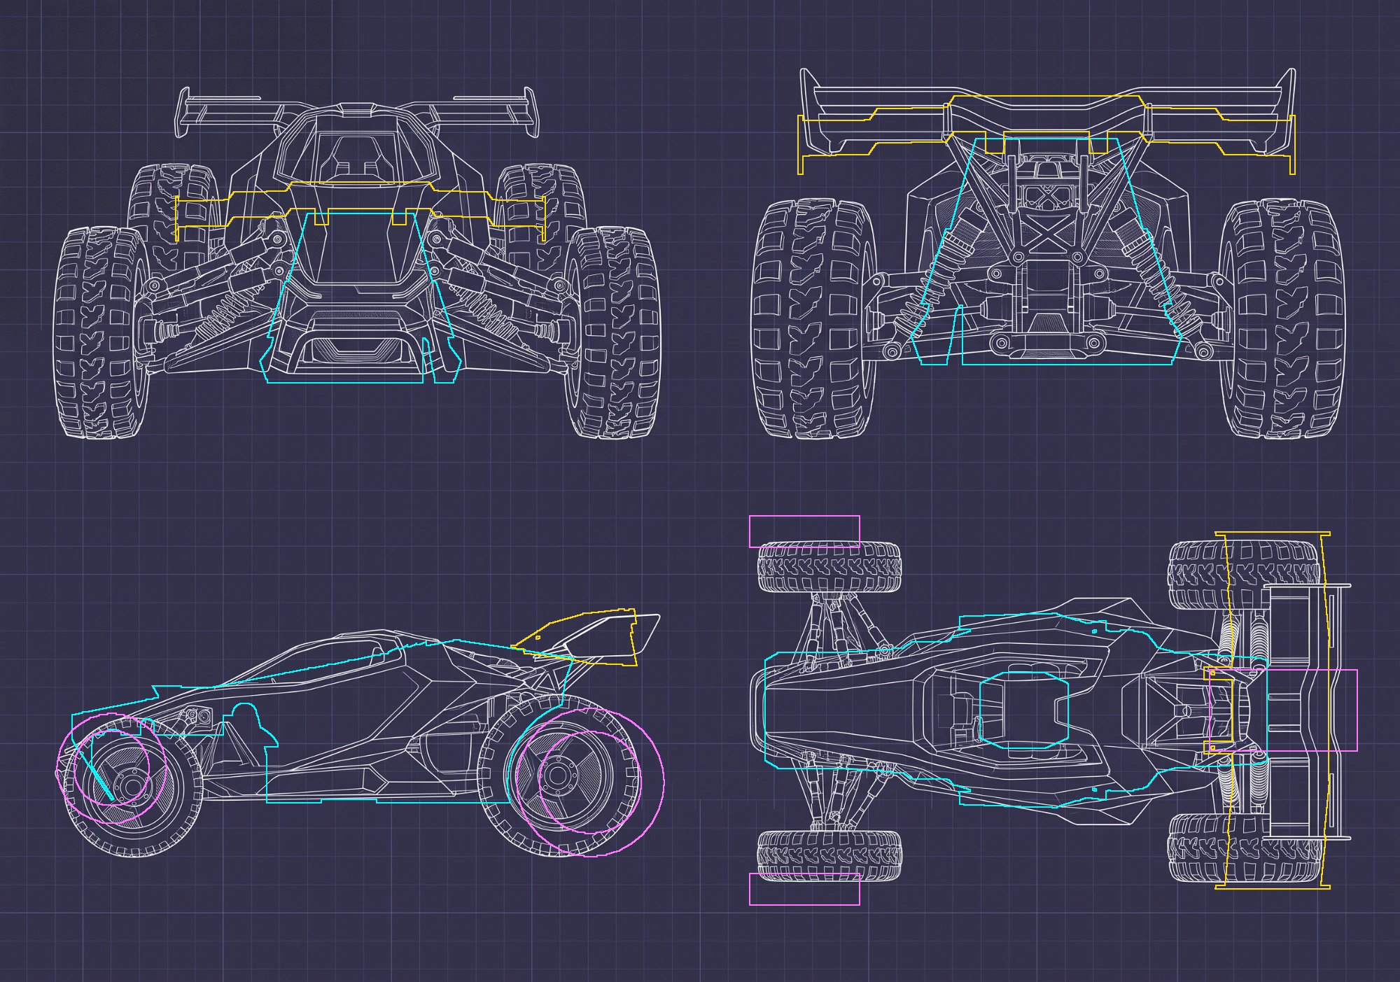
ws02/WS03_blueprint_overlay.png
