jdionaldo/sc-trike/ws02/WS03_restyle_overlay.png

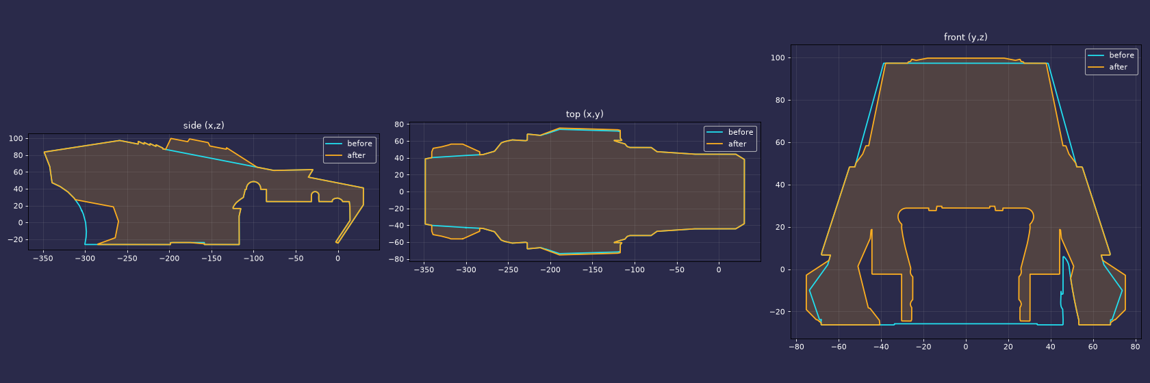
ws02/WS03_restyle_overlay.png
