jdionaldo/sc-trike/ws02/blueprint_shell/stl/P9.stl

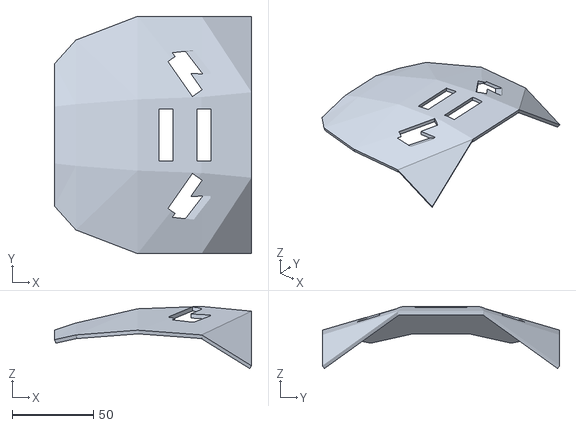
[picture p64: CAD file, 2026-11-10]
ws02/blueprint_shell/stl/P9.stl
121.2 x 146.0 x 38.2
