jdionaldo/sc-trike/ws02/skin_src/cache/cavity_front.stl

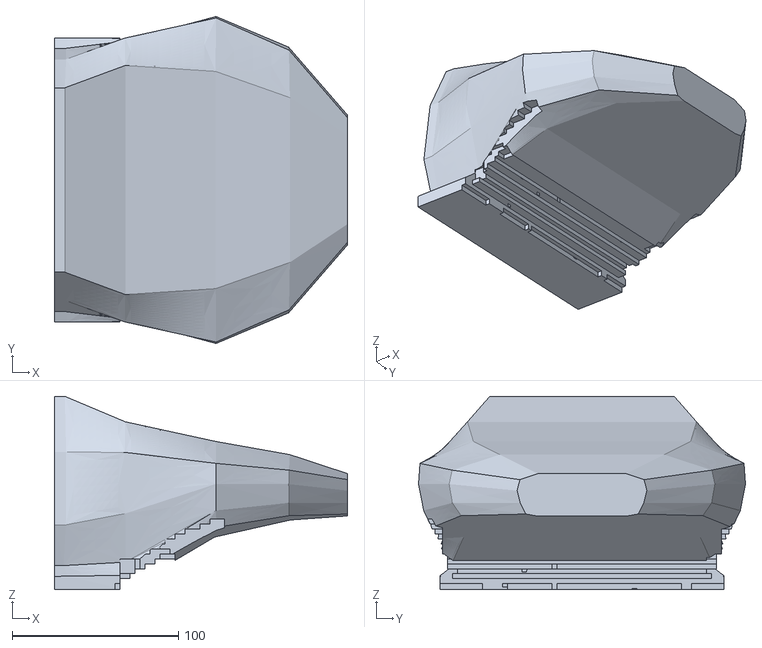
[picture p65: CAD file, 2026-11-09]
ws02/skin_src/cache/cavity_front.stl
176.6 x 196.9 x 116.4
