jdionaldo/sc-trike/ws02/skin_src/user_Cab.stl

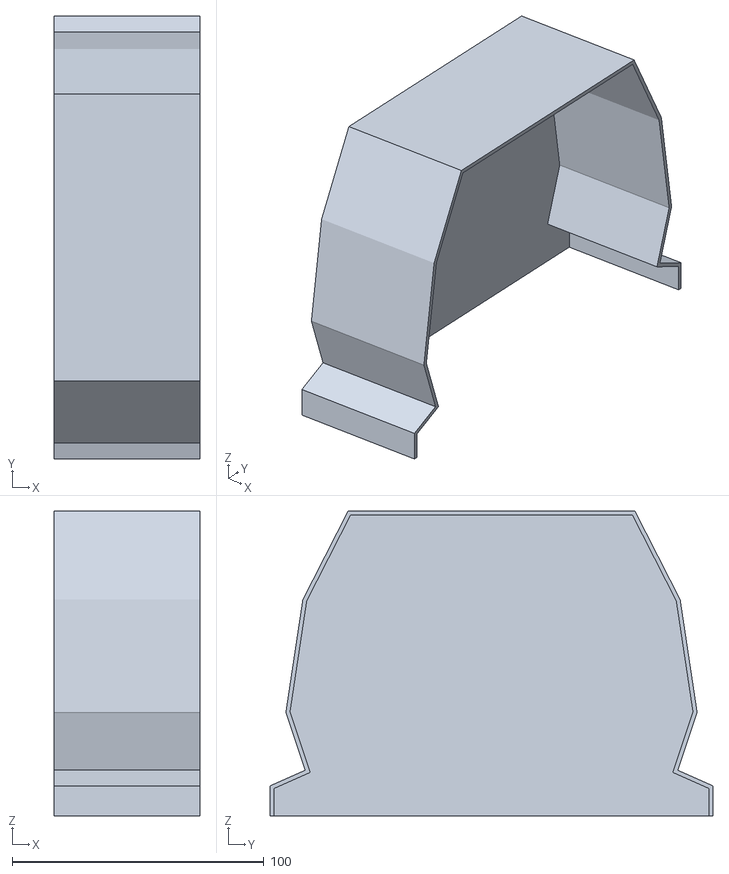
[picture p66: CAD file, 2026-11-09]
ws02/skin_src/user_Cab.stl
58.0 x 176.0 x 121.2
