jdionaldo/sc-trike/ws02/blueprint_shell/stl/P5.stl

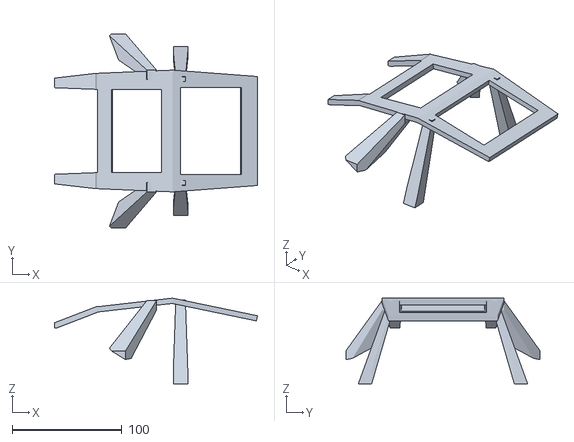
[picture p67: CAD file, 2026-11-10]
ws02/blueprint_shell/stl/P5.stl
185.0 x 177.2 x 78.1
