jdionaldo/sc-trike/ws02/skin_src/acc_g7.stl

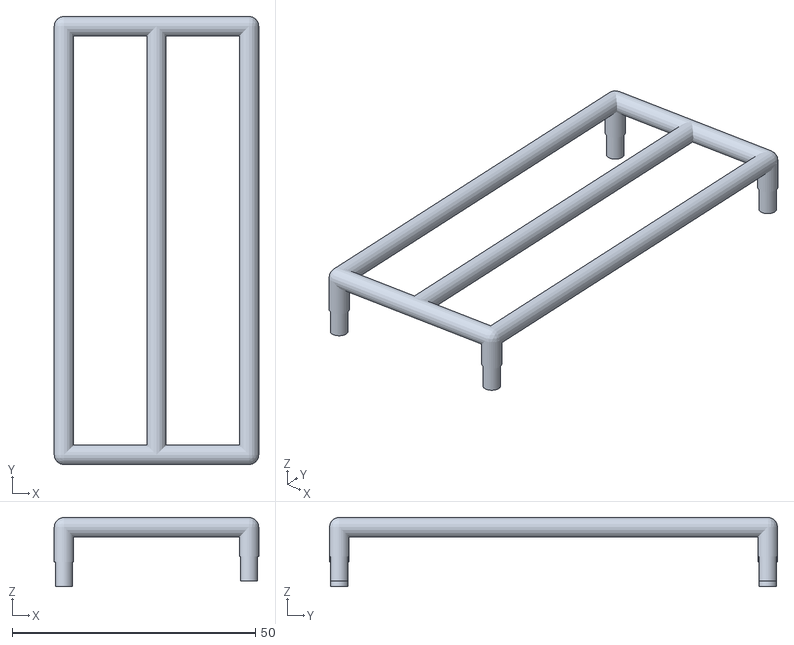
[picture p68: CAD file, 2026-11-09]
ws02/skin_src/acc_g7.stl
42.0 x 92.0 x 14.2
