jdionaldo/sc-trike/ws02/skin_src/cache/hollow_front.stl

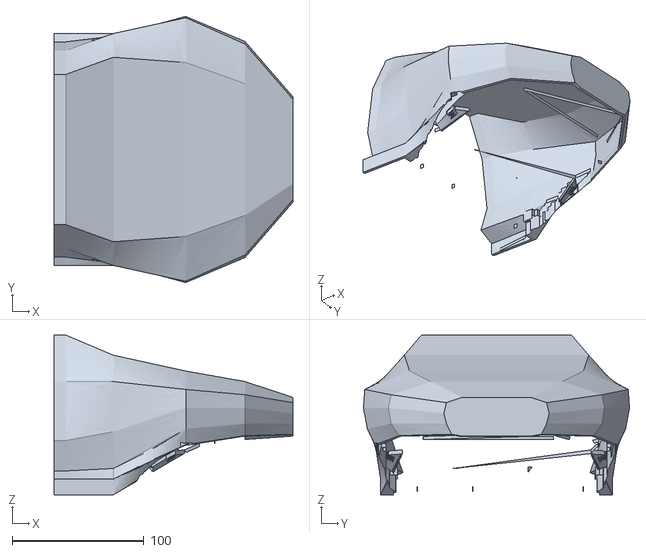
[picture p69: CAD file, 2026-11-09]
ws02/skin_src/cache/hollow_front.stl
181.4 x 202.0 x 121.2
