jdionaldo/sc-trike/ws02/blueprint_shell/stl/P8P10R.stl

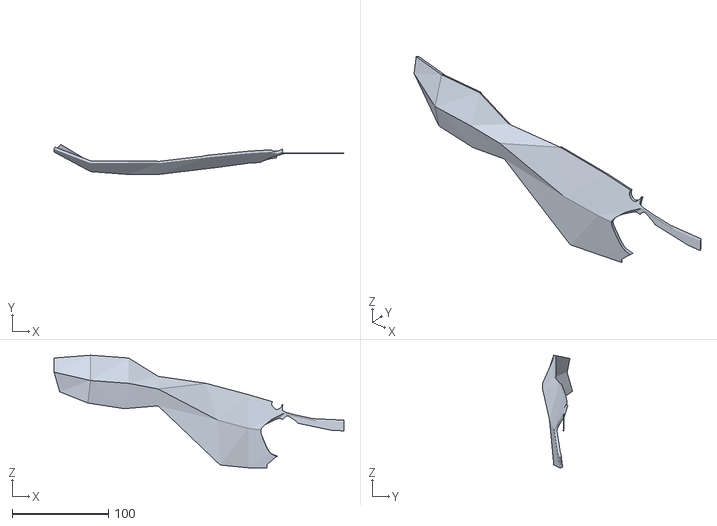
[picture p70: CAD file, 2026-11-10]
ws02/blueprint_shell/stl/P8P10R.stl
300.8 x 31.1 x 116.8
