jdionaldo/sc-trike/ws02/skin_src/acc_g4.stl

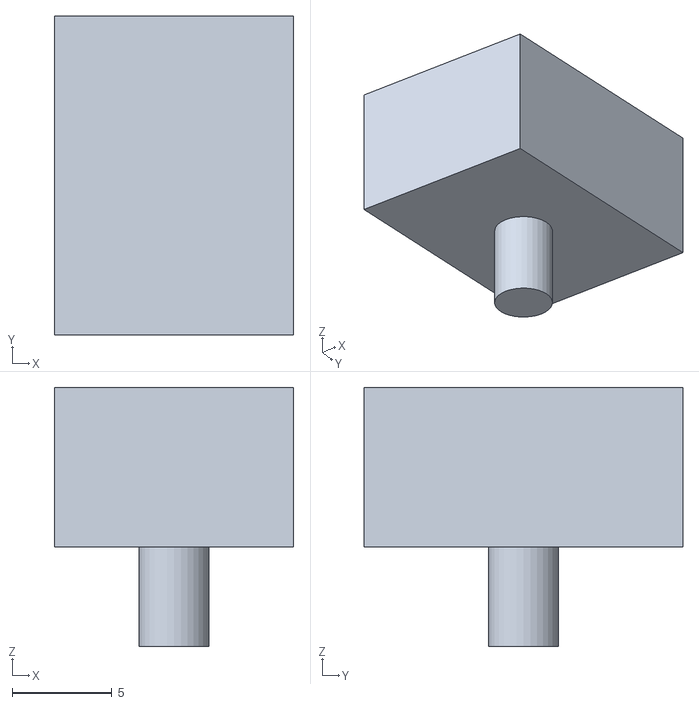
[picture p71: CAD file, 2026-11-09]
ws02/skin_src/acc_g4.stl
12.0 x 16.0 x 13.0
