jdionaldo/sc-trike/ws02/skin_src/cache/cavity_rear.stl

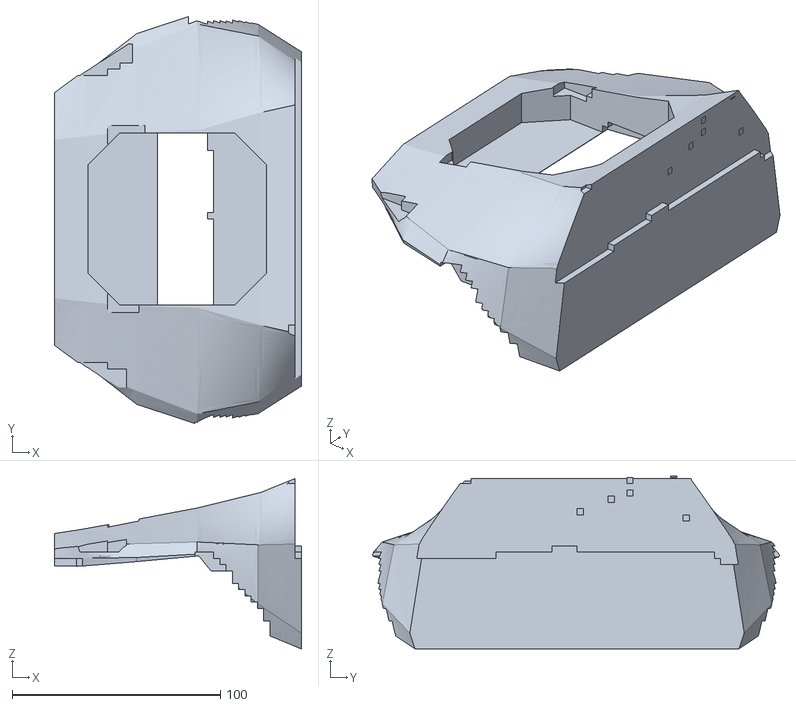
[picture p72: CAD file, 2026-11-09]
ws02/skin_src/cache/cavity_rear.stl
118.9 x 195.5 x 83.0
