jdionaldo/sc-trike/ws02/blueprint_shell/stl/P3.stl

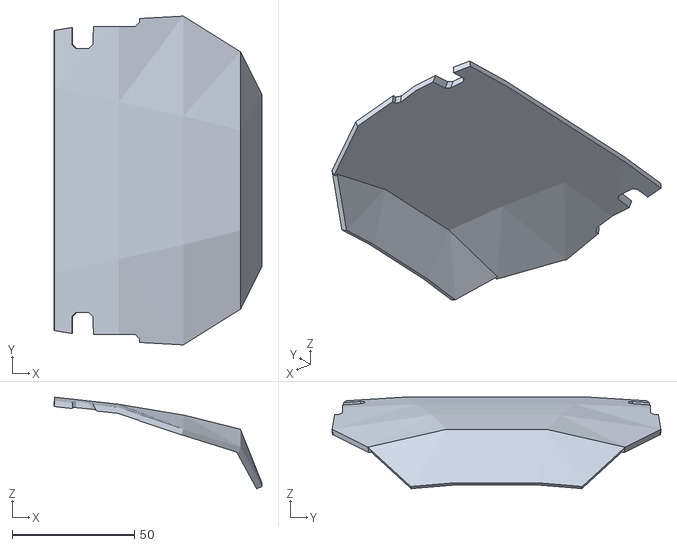
[picture p73: CAD file, 2026-11-10]
ws02/blueprint_shell/stl/P3.stl
85.0 x 134.3 x 37.5
