jdionaldo/sc-trike/ws02/skin_src/user_Rear_capped.stl

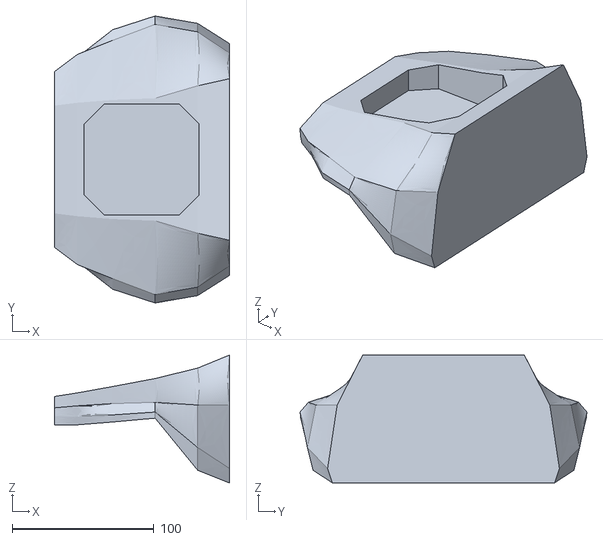
[picture p74: CAD file, 2026-11-09]
ws02/skin_src/user_Rear_capped.stl
123.5 x 202.4 x 90.2
