jdionaldo/sc-trike/ws02/blueprint_shell/stl/P4.stl

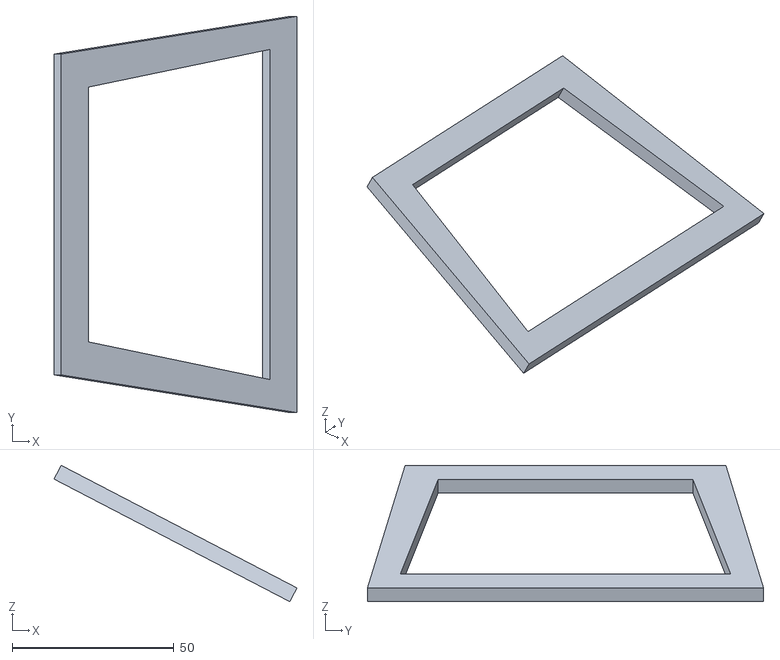
[picture p75: CAD file, 2026-11-10]
ws02/blueprint_shell/stl/P4.stl
75.2 x 122.6 x 42.2
