jdionaldo/sc-trike/ws02/skin_src/cache/hollow_rear.stl

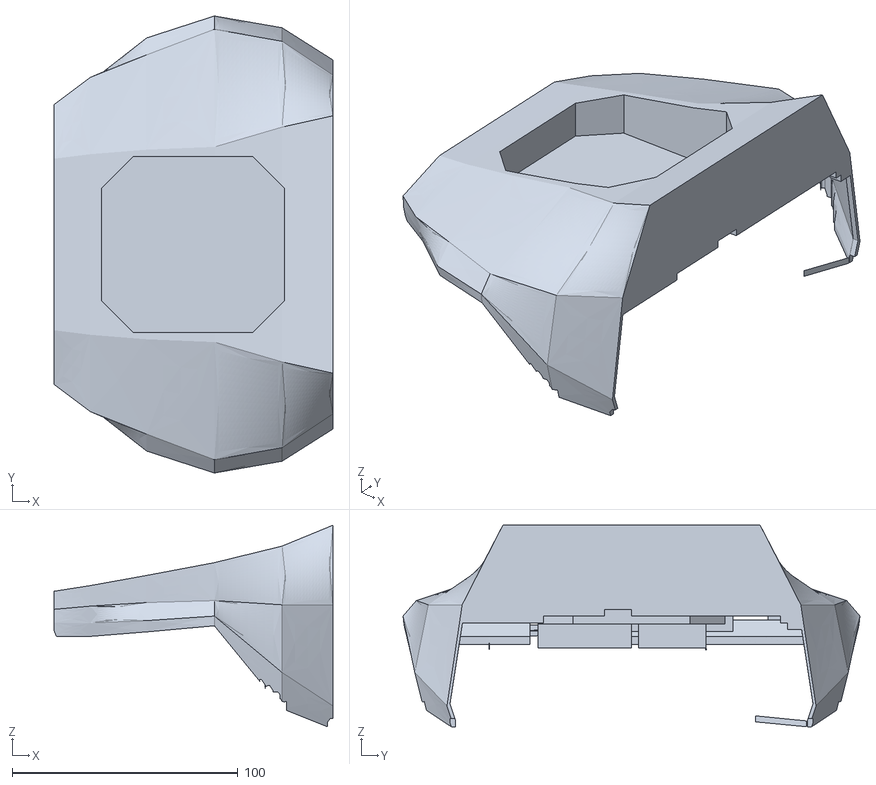
[picture p76: CAD file, 2026-11-09]
ws02/skin_src/cache/hollow_rear.stl
123.5 x 202.4 x 89.3
