jdionaldo/sc-trike/ws02/skin_src/cache/hollow_tail.stl

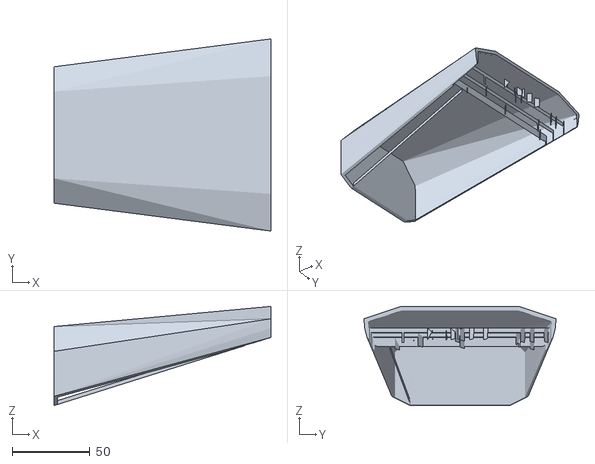
[picture p78: CAD file, 2026-11-09]
ws02/skin_src/cache/hollow_tail.stl
140.0 x 124.0 x 64.0
