jdionaldo/sc-trike/ws02/blueprint_shell/stl/P11.stl

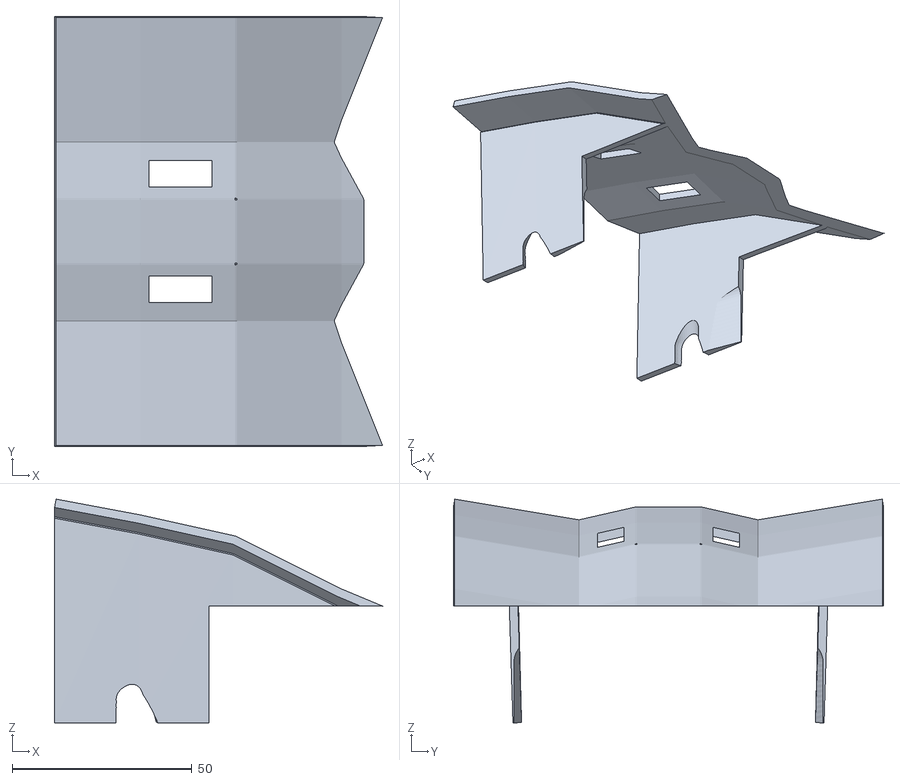
[picture p79: CAD file, 2026-11-10]
ws02/blueprint_shell/stl/P11.stl
91.3 x 119.7 x 62.3
