jdionaldo/sc-trike/ws02/skin_src/acc_g6.stl

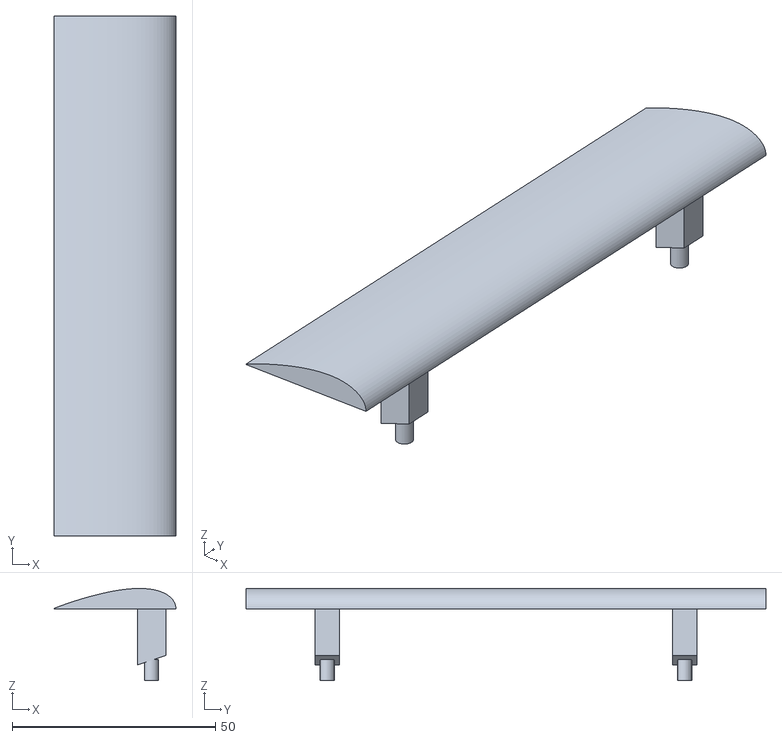
[picture p80: CAD file, 2026-11-09]
ws02/skin_src/acc_g6.stl
30.0 x 128.0 x 22.7
