jdionaldo/sc-trike/ws02/blueprint_shell/stl/P7R.stl

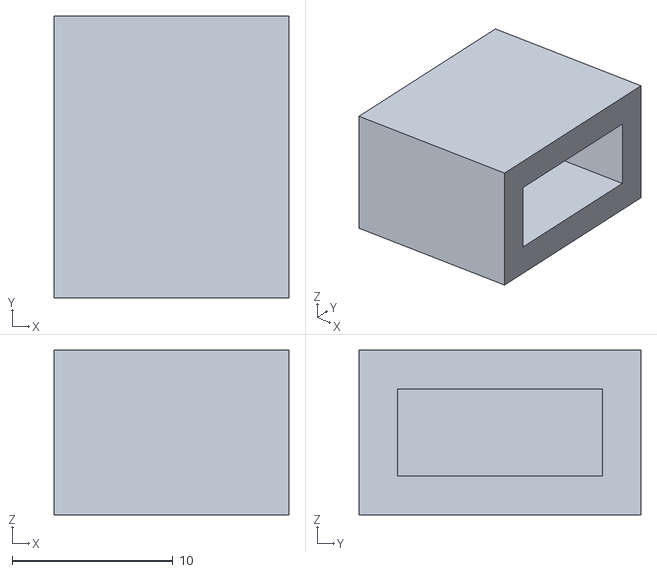
[picture p81: CAD file, 2026-11-10]
ws02/blueprint_shell/stl/P7R.stl
14.6 x 17.5 x 10.2
