jdionaldo/sc-trike/ws02/skin_src/user_Front.stl

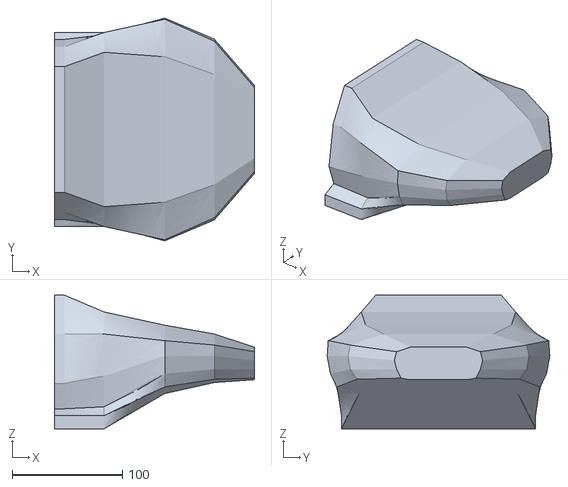
[picture p82: CAD file, 2026-11-09]
ws02/skin_src/user_Front.stl
181.4 x 202.0 x 121.2
