jdionaldo/sc-trike/ws02/blueprint_shell/stl/P6.stl

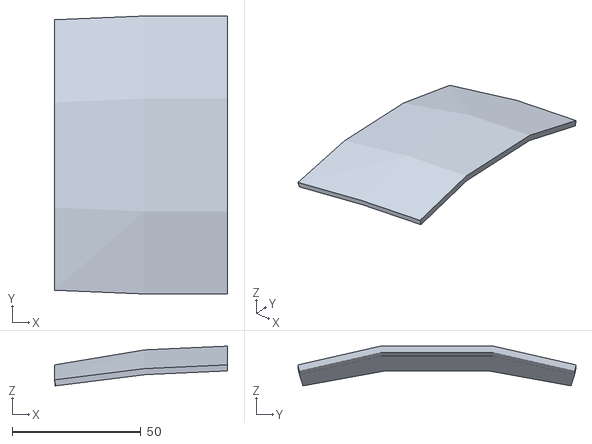
[picture p83: CAD file, 2026-11-10]
ws02/blueprint_shell/stl/P6.stl
67.3 x 108.0 x 15.5
