jdionaldo/sc-trike/ws02/blueprint_shell/stl/P2R.stl

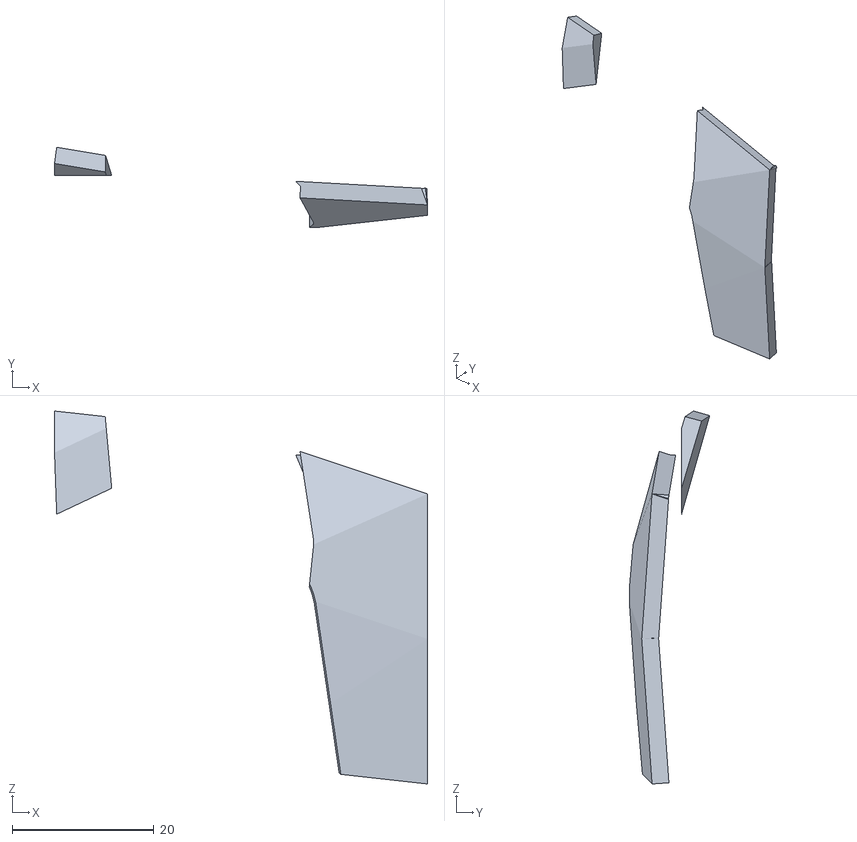
[picture p84: CAD file, 2026-11-10]
ws02/blueprint_shell/stl/P2R.stl
52.6 x 11.3 x 52.6
