jdionaldo/sc-trike/ws02/blueprint_shell/stl/P1.stl

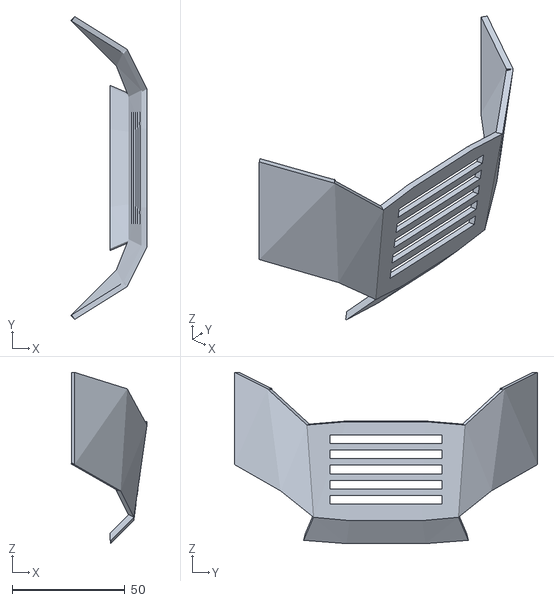
[picture p85: CAD file, 2026-11-10]
ws02/blueprint_shell/stl/P1.stl
33.7 x 134.3 x 75.9
