jdionaldo/sc-trike/(list of files, cad)

Other CAD files:
ws02/blueprint_shell/stl/P8P10L.stl
ws02/skin_src/acc_g5.stl
ws02/blueprint_shell/stl/P7L.stl
ws02/blueprint_shell/stl/P2L.stl
ws02/skin_src/cache/hollow_rear_old.stl
