jdionaldo/sc-trike/ws02/print_plan.md

# Print plan

Slicer defaults: 0.4 mm nozzle, 0.2 mm layers, 3 perimeters (1.2 mm walls), no supports except the three monocoque parts (supports on, shell halves turned about 40 degrees on the bed), no brim unless a part lifts. Structural parts 30% gyroid, body panels 15%. Times and masses are estimates from part volume (9 mm3/s, x1.35 overhead).

| Part | Qty | Material | Orientation | Extent mm | Infill | Mass g (each) | Est. time h (each) |
|---|---|---|---|---|---|---|---|
| hub_left | 1 | PETG | stub axle up, inboard face on bed, kingpin bore horizontal | 26.6 x 23.7 x 47.0 | 30% | 11.3 | 0.4 |
| hub_right | 1 | PETG | stub axle up, inboard face on bed, kingpin bore horizontal | 26.6 x 23.7 x 47.0 | 30% | 11.3 | 0.4 |
| lean_bar_upper | 1 | PETG | flat on its side, pivot bores vertical | 199.9 x 8.9 x 14.8 | 30% | 18.5 | 0.6 |
| lean_bar_lower | 1 | PETG | flat on its side, pivot bores vertical | 199.9 x 23.7 x 14.8 | 30% | 19.6 | 0.6 |
| upright | 2 | PETG | on its side, pivot bores vertical, kingpin socket near-horizontal | 8.9 x 56.2 x 11.7 | 30% | 5.1 | 0.2 |
| rod_drive | 1 | PETG | flat, bores vertical | 22.8 x 8.0 x 5.2 | 30% | 0.9 | 0.0 |
| link_steer | 2 | PETG | flat, bores vertical | 71.5 x 10.4 x 5.2 | 30% | 3.0 | 0.1 |
| link_bracket_left | 1 | PETG | plate on bed, standoffs up | 63.3 x 24.9 x 16.9 | 30% | 5.1 | 0.2 |
| link_bracket_right | 1 | PETG | plate on bed, standoffs up | 63.3 x 24.9 x 16.9 | 30% | 5.1 | 0.2 |
| swingarm_arm | 1 | PETG-CF | outer face on bed, gear cavity open upward | 126.0 x 91.5 x 19.8 | 30% | 69.7 | 2.2 |
| swingarm_cover | 1 | PETG | outer face on the bed, open side up | 117.6 x 61.1 x 8.0 | 30% | 21.7 | 0.7 |
| chassis_tub_left | 1 | PETG | outer wall on bed, split face up | 160.0 x 103.6 x 47.0 | 30% | 81.2 | 2.7 |
| chassis_tub_right | 1 | PETG | outer wall on bed, split face up | 160.0 x 103.6 x 44.0 | 30% | 74.7 | 2.4 |
| front_yoke | 1 | PETG | front face on the bed, beams up | 71.0 x 103.0 x 24.6 | 30% | 55.2 | 1.8 |
| chassis_cradle_left | 1 | PETG | outer wall on bed, split face up | 63.9 x 82.9 x 36.0 | 30% | 30.7 | 1.0 |
| chassis_cradle_right | 1 | PETG | outer wall on bed, split face up | 63.9 x 82.9 x 33.0 | 30% | 31.1 | 1.0 |
| motor_flange | 1 | PETG | flange down, boss up | 24.0 x 24.0 x 4.9 | 30% | 1.6 | 0.1 |
| rx_mount | 1 | PETG | flat | 25.4 x 16.4 x 8.9 | 30% | 1.6 | 0.1 |
| battery_mount | 1 | PETG | flat | 65.4 x 23.4 x 11.8 | 30% | 5.6 | 0.2 |
| rear_hub | 1 | PETG | hex standing on the bed | 13.9 x 12.0 x 17.8 | 30% | 1.6 | 0.1 |
| mono_left | 1 | PETG | chassis frame, supports, turned on the bed | 225.9 x 61.9 x 115.1 | 30% | 168.1 | 5.5 |
| mono_right | 1 | PETG | chassis frame, supports, turned on the bed | 225.9 x 58.9 x 115.1 | 30% | 171.5 | 5.6 |
| canopy_lid | 1 | PETG | chassis frame, supports, turned on the bed | 79.5 x 67.5 x 37.8 | 30% | 21.8 | 0.7 |

Totals: 25 printed pieces, about 824 g of filament and 27 printer-hours.

Materials: PETG-CF for the swingarm halves, gearbox and hatch (heat); PETG elsewhere. ASA or PC are acceptable substitutes for the swingarm; never PLA near the power unit.
