jdionaldo/sc-trike/(commit log)

2026-10-31 1/18 lean-steer trike and WS-02 370 mm rebuild (SolidCraft command scripts, validators, body)
2026-10-31 WS-02: traced-look experiments (hull sections from reference silhouettes, traced yellow panel polygons)
2026-10-31 Blender sculpt of the traced faceted body (headless script, side/iso/top renders)
2026-10-31 Body from panel-kit sheet: traced envelopes and yellow areas (still a blob, not reference quality)
2026-11-01 RT-1: faceted hull traced from the Hammerhead sheet (plan, roof, belly lines; dark panel sampling)
2026-11-01 Single-sided swingarm: fixed motor with flange boss, one-piece arm with gear/belt train and cantilever axle, narrow cradle, ESC above battery
    [assembly.py, params.py, validate.py]
2026-11-01 RT-1 shell halves fitted around the single-sided-swingarm chassis; old procedural body removed
2026-11-01 Base-model tires and narrower tub; shell extraction scripts (base model itself not committed)
2026-11-01 Monocoque halves (shell fused with tub and cradle), tail hood, roof lid, swingarm cover; docs refreshed
2026-11-01 Print plan header: supports for the monocoque parts
2026-11-01 Smooth monocoque skin (Gaussian blur before marching cubes); restore 233 mm front end
2026-11-01 Front end: per-wheel steer servos on the lean bar with tie rods replace the lean-to-steer coupling links
    [assembly.py, kinematics.py, params.py, report.py, validate.py]
2026-11-01 S2: front kinematics (arm swing, lean horn solve), layout update
2026-11-01 S2: WS-03 front arm, cover, upper link, carrier, knuckle, rods; pose sweep with zero interference
    [w3_check.py, w3_scene.py]
2026-11-01 S2: steering geometry reworked (cantilever kingpin, steer rod clear of arm); 39-pose sweep clean
    [w3_scene.py]
2026-11-01 S3: drivetrain layout with 4 deg rake, big rear tire, bevel gearing decisions
2026-11-01 S3: split bevel/diff housings, slotted motor plate and trays, rear swingarm housing; wheelbase 360
2026-11-01 S4a: stretched 3WD shell with arm windows, split into bed-sized pieces; shell look still needs redesign
    [mono3_build.py, mono_shell.py, split_shell3.py, w3_interior_check.py]
2026-11-01 S4b: procedural faceted body from base.stl silhouettes (windows, panels, vents, hatch), split for the bed
2026-11-01 S4b: widen front body so the servos fit; window margin 5.5 mm; checks clean
2026-11-01 WS-03: 269 mm front track, lean max 25 deg, servo walls on diff-case ears, decks; all clash checks clean
2026-11-01 WS-03: detailed body (pads, posts, seam bosses, honeycomb vent, light bar, antenna), decks, wings, skid, global assembly check, 44 new tests
2026-11-01 WS-03: wings in the pose check, report, BOM, README, spec
2026-11-01 WS-03 body finish: canopy recess, roof spine, motor grilles, tail light slot, panel tweaks, paint guide
2026-11-01 WS-03: angular snub nose with four cooling slots; skid plate narrowed
2026-11-01 WS-03: mock drivetrain placed and clash-checked (gears, pulleys, belts, joints, wheels, rear belt); front belt 20T to 16T
2026-11-01 WS-03 body per markup: raised long scoop, open tail under a hood with bulkhead, wider nose, rocker armor band; motor plate on the bulkhead
2026-11-01 WS-03: flat snub nose with angled bottom, shoulder frame around the wheel opening, upper-link standoff; 110 tests
2026-11-01 WS-03: mass/CG report, strength checks (4 mm kingpin, steel tie rods), painted GLB and Blender renders, 112 tests
2026-11-02 WS-03: styled arms, swingarm, covers, links and servo walls; overhanging snub nose with angled skid; 112 tests
2026-11-02 crisp angular wing fenders; fix Blender render camera clip so iso render shows the vehicle
2026-11-02 styled carriers and knuckles: tapered carrier post, chamfered tab, faceted knuckle with chamfered steering beam
2026-11-02 tubular space frame replaces servo walls: angled ladder, pivot hoop, swept rails, rear hoop, skin tabs and bosses; 49 tests
    [body3_build.py, w3_assembly.py, w3_check_chassis.py]
2026-11-02 frame beam-model stiffness check (w3_frame_fe.py)
    [w3_frame_fe.py]
2026-11-02 frame rebuilt as triangulated tube graph on a 6 mm base plate: strut feet screwed into the plate, front roof tabs replace body posts, X diagonals, thicker roof tubes; FE: 1-2 mm vertical/aft, 5-8 mm 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
    [body3_build.py, w3_assembly.py, w3_frame_fe.py, w3_report.py]
2026-11-02 thicker frame tubes (8-11 mm roof/hoop, 9 mm rails), second hoop strut and rear flank strut for lateral stiffness, 4.5 mm wing fenders, roof tabs moved clear of the hatch
    [body3_build.py, w3_scene.py]
2026-11-02 remove the wing fenders (cosmetic only, crash-prone); tubular wing variant kept in w3_style.wing for reference; 46 tests
    [w3_scene.py]
2026-11-02 tidy: remove walls, body posts, wings, old carrier/knuckle and unused imports; lateral truss at the pivot hoop; fix FE model (pivot pad was not tied to the hoop leg); 111 tests
    [body3_build.py]
2026-11-02 frame: fix centre bar trim, clean degenerate faces before STL export (front pieces were non-watertight after the truss change); tests pass
2026-11-02 trellis redesign: box-truss swing arms (inner zigzag plane, outer rails, belt between), spindle upper links, tubular carriers and knuckles; mesh cleanup; 46 WS-03 tests pass
2026-11-02 front arms: remove the cover plates, outer rails thickened (merge with inner plane into a 10 mm wide truss), old arm/cover/uplink code deleted; 44 WS-03 tests pass
2026-11-02 wide box-truss arms: two side planes with the belt between them, X lattices in the top and bottom faces, outer hubs with bearing seats; diff output shaft extended to carry the outer bearing; 44 WS-03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
2026-11-02 rear arm as wide box truss (belt between planes, wider tie pairs, no cover), strength checks rebuilt on real tube graphs (beam FE), V-tube steering arm, base plate head channels and counterbores, lev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
2026-11-02 overbuilt arms: 9 mm outer rails and 7 mm outer zigzag on the front arms (outer plane at 80 mm, belt between), heavier lattice/ties and a third tie pair on the rear arm; FS front 3.8, rear 5.2; 43 WS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
2026-11-02 new rear profile with tail-light face, skid mounted on tube struts from the base plate through the nose skin, beefier carrier, headlight pods on the front arms; 44 WS-03 tests pass
2026-11-02 smooth base plate outline; flared rocker panels; gill vents (roof and flank, openings rearward, mirrored); antenna removed; whale tail as wide as the front track on frame struts; 47 WS-03 tests pass
2026-11-02 GT wing on swept legs (blade follows the front roofline, 269 mm with end plates); louvred nose intake; exhaust gills covered by blades in recessed pockets; 49 WS-03 tests pass
2026-11-02 wing moved 29 mm rearward: legs start mid back-slope, blade overhangs the tail; mesh cleanup keeps slivers that close the surface; 49 WS-03 tests pass
2026-11-02 wing rebuilt after the reference (arched, swept blade with centre hump and spoon lip, small swept end fins, tapered pylon legs); roof louvers flipped to open rearward; 49 WS-03 tests pass
    [body3_build.py]
2026-11-02 polish: rounded tube ends everywhere (no open joints), hull-built angular rocker bulge replaces the noisy mesh flare, roof hatch removed and filled, wing top on the front roofline plane, wider closed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
    [body3_build.py, w3_assembly.py, w3_paint.py, w3_report.py]
2026-11-02 roof spine removed (flat roof); wing reworked: angular dihedral blade (flat centre, straight outer panels), cap that wraps the blade, swept wedge end fins; 49 WS-03 tests pass
    [body3_build.py]
2026-11-02 wing mount reshaped: leg feet pass through slots in the back slope and sit on frame pad plates inside the hood, screws from below through access holes; blade-leg screws from below via a flange; legs 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
2026-11-02 wing mount: integral sloped wedge under the blade filling the gap to the back slope, two feet through hood slots, screws from below; separate legs removed; 47 WS-03 tests pass
2026-11-02 wing: raised cap and solid wedge block deleted; mount is two thin sloped web plates from the back slope to the blade's rear, feet through hood slots; 47 WS-03 tests pass
2026-11-02 wing mount as a hanger: web plates rise from the back slope over the blade's leading edge and run along its top face; feet through hood slots, screws from below; 47 WS-03 tests pass
2026-11-02 wing hanger as a fork: separate hanger parts with upper and lower prongs and a riser, blade slides in from the rear, two screws from below through the lower prong; feet through hood slots; 49 WS-03 t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
2026-11-02 fork hanger: snug 2 mm prongs follow the blade profile in matching channels, end chamfers (down on top, up underneath), chamfered web and cap, screws from below into the blade core; blade end fins ha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
2026-11-02 roof louver slots covered (slanted cut now crosses the surface under the wedge); grate married to the base plate (foot tab in an underside rebate, countersunk screws); frame extended to the bumper wi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
    [body3_build.py, w3_assembly.py]
2026-11-02 fork prong ends square to the channel end plane (chamfer down to a 1 mm 90-degree end); skin-to-cage screws removed (roof tabs, skirt pads), hood magnet seats (6x2 mm) in frame pads and skin bosses; 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
    [body3_build.py]
2026-11-02 weld panels: body 4->2 pieces, frame 4->2, blade 3->2 (no y seams); x seam gap 0.025 mm; fork channel shortened with square prong ends (no wedge); LED row centred on the nose face; clearance check + 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
    [body3_build.py, split_shell3.py, w3_assembly.py, w3_clearance.py, w3_report.py]
2026-11-02 flank vent opens through the scoop's rear face; flat flank (no recessed panels), tight tube slots; straight floor opening (no sawtooth lower edge); swing channels for the frame tubes; one-piece hange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
    [body3_build.py, w3_swing.py]
2026-11-02 swing channels include pads, lugs and plates plus the rear case and base plate; fine-step check: skin clears everything but the wing through 35 deg; clearance report refreshed; 46 WS-03 tests pass
    [w3_swing.py]
2026-11-02 hanger web same width as the fork and foot (10 mm); 46 WS-03 tests pass
2026-11-02 wing mounts to the skin (feet on the hood, screws from inside, no frame pad or hood slots) so it flips up with the skin; swing check clean 0-35 deg incl. wing; fork prongs and channels extended rearw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
    [body3_build.py, w3_swing.py]
2026-11-02 rear walls removed: skin side and rear wall moved back past the rear tube frame (x -299) and the flank filled in, belly open to the new wall, plan narrowed to clear the rear arm; flank vent enlarged;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
    [body3_build.py]
2026-11-03 rear wall/flank solid down to the base and hugging the rear tube frame (arm-exit windows removed, arm carved instead); hood scoop (50% width); tie and lean rods as round tubes; grille: big X plus sid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
2026-11-03 cleanup: stale STL/code/frame strut/bulkhead cuts removed, deck seam flush; grate extended to just below the bumper bar with a top chamfer and no screw holes through the skin; scoop moved back, leani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
2026-11-03 wing swept forward (outer panels), left and right panels verified mirror images; 46 WS-03 tests pass
2026-11-03 vents reopened (exit channel follows the flank), flank vent moved clear of the plan kink; skin rear edge follows the wheel radius; rocker tapered with no ledge or rear facets; LED row centred on the 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
2026-11-03 BOM: Axial SCX10 III stock drivetrain candidates from the AXI03007 parts list (names and part numbers only, dimensions still to be measured)
2026-11-03 BOM: keep the centre differential (same Axial diff set as the front, optional locker for crawling)
2026-11-03 base plate redrawn along the cage: diagonal out from the nose, straight run, one long diagonal in to the tail; both decks share the outline (flush seam), no outboard tab or notches; servo pockets; 46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
2026-11-03 stepped wing (centre plus two flat steps down, angled risers), open canopy cut, frame feet filleted to their nodes, unused tray rail slots removed, blueprint overlay; 46 WS-03 tests pass
2026-11-03 front tyres to the rear size (112 x 62, track 288, lean limit 20 deg), rear wheel travel carved into the skin (25 mm bump, 20 mm droop) with a travel test, electronics and mechanical fit check (WS03_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
2026-11-03 BOM: motor on the side opposite the driveline (y -21), balance numbers and the cross-over reduction it needs
2026-11-03 WIP: wheelbase 450 (shared stretch constant, rear shifted 90 mm, 3-piece skin split); body not yet watertight, tests not run
2026-11-03 WS-03 cleanup: drop unused servo-ear pads (PS2, PS1, PE1 on -y) and dead helpers, 4.5 mm hinge lug, flared hood-tab pad, rounded ear plate, w3_joint_check.py, WS03_CLEANUP.md; 51 WS-03 tests pass
2026-11-03 wheelbase 450: pad the arm channel at the pivot (skin watertight), rear base plate split in two, 52 WS-03 tests pass, swing clean to 35 deg
2026-11-03 motor to x -100 / y -21 / z 41 (left half of the pivot hoop opened around it), roof raised ahead of x -70 (63 mm) to cover it, front and rear tyres 95 g each; front weight share 64.1 %; 52 tests pass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
2026-11-03 WS-03 skin: single sill step, plain rear fender, one straight trim over the rear arm travel envelope, covered canopy over the hourglass cut; 51 tests pass, 1 deg swing clear
2026-11-03 WS-03 rear coilover: lug on the swing arm, tube-and-plate tab on the cage through the skin, b_rear_shock mock (55-80 mm, 25 g); eye to eye 60.5 / 71.6 / 79.5 mm over 25 mm bump to 20 mm droop; shock 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
    [w3_assembly.py, w3_mass.py, w3_strength.py]
2026-11-03 Restore 4 deg nose-down rake (rear axle z -31.5): wheel arch arc starts at the skin floor, belt and pulleys carved into the arch sweep, boolean chain evaluated between cuts so the skin stays watertig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
2026-11-03 Skin: tapering shoulder crease (full at the rear), side pods with waist line, louvered flank intake tapering down; wing back to its pre-stretch pitch and height with the top surface curving up toward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
2026-11-03 WS-03 lean drive: one INJS15 on the centreline with a V rocker and two ball-link rods, printed servo tower (portal over the battery), lean trays and pockets removed; motor 22 mm aft (x -122), battery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
2026-11-03 Canopy as a cage (flat roof slab, diagonal pillars, open windows and windscreen per the owner's top-view sketch); roof louvers replaced by one big forward-facing air dam; 52 tests pass, swing clean
    [body3_build.py]
2026-11-03 WS-03 belt cross-over: motor shaft extended aft over the centre-diff case to a 16T GT2 pulley, belt to a 40T pulley on a pinion countershaft (y 21, z 24); mocks, mass and BOM; 60 tests pass, clearanc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
    [layout3wd.py, w3_mass.py, w3_mock.py]
2026-11-03 Wing side profile: blade top now built from PROF_TOP (it was hard-coded): straight rise plus an upturned flick at the trailing edge, fork channels follow; 52 tests pass
2026-11-03 Rear shock moved inside the body: a hoop on the swing arm (two legs behind the tyre, cross tube over it) carries the lower eye, upper lug on the cage's rear hoop; shock envelope carved into the skin 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
2026-11-03 Wing: one step down, constant-thickness blade following the profile, hanger prongs and channels follow, end plates removed; reversed roof air dam (opening to the rear); canopy cut follows the pillar 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
    [body3_build.py]
2026-11-03 Wing: two-segment top profile (one crease at the flick), channels and hanger bends match; roof gill slits restored behind the canopy; flank louvers replaced by one big forward-opening air intake; 52 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
    [body3_build.py]
2026-11-03 WS-03 battery beside the drive shaft (y -37.5..-2.5, x -77.5..-2.5, z -11..14) on a printed cradle with strap slots; lean tower open under the servo window; skin swing channels include the pack; fit 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
2026-11-05 Longer swing arm (pivot, rear bevel case, pulley, R1/FPR 30 mm forward; arm 122 mm), top rail bent into an asymmetric up-caret (apex at 30 %, 16 mm), hoop leg from the apex, cage rail R1-R2 rerouted 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
    [body3_build.py, layout3wd.py, w3_mock.py, w3_strength.py]
2026-11-08 ws03-integrated: regenerate clearance, fit, mass reports; BOM for merged layout
2026-11-08 Fix swing pivot pad swallowed by a comment (sat at origin and stretched the arch trim hull over the flanks): full skin restored, body 256,592 mm3; 61 tests pass, 1 deg swing sweep to 35 clean, front 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
    [w3_swing.py]
2026-11-08 WS-03 lean actuation through two coilover links (rocker tip to arm lug, 51.5-75.5 mm eye to eye, 71 % extended at lean 0, 67.9-69.9 mm over +-20 deg): rocker refit (x -82, z 34.5, R 17.3), tower trim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
    [w3_mass.py, w3_scene.py]
2026-11-08 Drivetrain redrawn around stock parts: AXI232003/232002/232033/232034 gears, 13T-27T-27T-40T cross-over, split housings, pillow block, ring hubs, bolt slots; ratio 9.23:1; docs, BOM, tests
2026-11-08 WS-03 wing foot: 2 screws per hanger, 6 mm foot slab, foot 13.5 mm wide, washers; abuse press FS 0.68 -> 1.93; strength review files copied in and foot model reads the geometry
2026-11-08 WS-03 cage fixes: front ring tubes r 3.0 to 4.5, rear shock-tab tubes and bumper bar r 4.0/4.5 to 5.5, rear feet 11.5 mm; all 9 cage rows pass (front bump 1.45 to 4.87, rear shock tab 1.58 to 2.70, s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
    [w3_strength_report.py, w3_strength_review.py, w3_strength_validate.py]
2026-11-08 WS-03 strength fixes: front arms, carrier, kingpin, uplink, knuckle, rocker, tower, rear hoop
    Front arm 3 g bump 0.39 -> 3.09, carrier 0.73 -> 3.36, kingpin 1.32 -> 2.57, uplink 1.69 -> 2.54, tower screws 1.15 -> 2.3, rear arm bump 0.92 -> 2.48 (still < 3.0). Mass 2252 g, front share 62.9 %.
    [w3_scene.py, w3_strength_fixes_try.py, w3_strength_report.py]
2026-11-08 WS-03 rear arm: fatter rails, end ties and lattices; 3 g bump 2.48 -> 3.06, lateral 2.27 -> 3.09
    160 W3/strength tests pass; mass 2261 g, front share 62.7 %.
2026-11-08 WS-03 rear arm: 1 m drop analysis (energy balance, bump stop options); row stays 0.33
2026-11-08 WS-03 cage: add PM-PL diagonal (r 3.0, ear plate up to the pivot pad, in the y 54.5-60.5 pad layer, no thicker front ring); arm-pivot rows 1.89/0.94/1.82/1.94 to 6.34/3.17/4.86/5.09; 163 tests pass, 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
2026-11-08 WS-03 balance: front share 63.0 to 64.4 %, CG height 54.2 to 52.3 mm
    125 g pack, small-mass inventory, wing/tail infill 8 %, 42 g tungsten nose ballast in a carrier under the front deck (parts/w3_balance.py, clash and swing clean), mass ladder, balance tests, BOM.
2026-11-08 Skip the second legacy test that needs mono_left.stl
2026-11-08 WIP cage motor bypass: -y hoop/roof tubes rerouted outboard of the can (N1, N2 nodes, 6 tubes r 3.0), -y copies of the cut tubes dropped, C40/XH column and HT-C100 removed; FE hooks added; tests, fit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
2026-11-08 Cage motor bypass verified: 169 tests pass (1 xfail = rear 1 m drop), clearance clean, swing sweep clean to 35 deg, mass 2300 g / front 64.2 %; legacy frame FE drops orphan nodes
    [w3_frame_fe.py]
2026-11-08 Cage motor bypass made mirror-symmetric: inner roof/hoop rails run outboard of the can on both sides (N1, N2), HT/HT2 rails and -y-only tubes removed, roof cross MU-MC behind the can restored, PS2-N2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
2026-11-08 Legacy w3_strength frame FE: join the two copies of the cross-tube node MC (0.4 mm off y=0) so it is no longer a floating leaf (singular matrix in test_strength_factors); legacy frame factor 4.6, cal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
    [w3_strength.py]
2026-11-09 WS-03: user's hand-edited skin (WS03_graft_v3_after.sc) hollowed 2.4 mm, fitted to the cage (front/mid/rear/tail pieces, arm arches, dowels, magnet tabs), cage rails lowered under the hatch pocket, b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
    [acc_g4.stl, acc_g5.stl, acc_g6.stl, acc_g7.stl, cavity_front.stl, cavity_rear.stl, hollow_front.stl, hollow_rear.stl]
2026-11-10 WS-03 skin re-split: front to the old end of the cab, mid moved back 57.5 mm, rear top opened; no clashes, swing clean to 35 deg, front share 64.5 %
2026-11-10 WS-03 skin: close the rear-quarter opening with faceted side skirts; fender-corner wedges are arm clearance (documented); no clashes, swing clean to 35 deg
    [skin_user.py]
2026-11-10 WS-03 skin: rear-quarter skirt cut to the user's outline and merged into the running board
2026-11-10 WS-03 skin: rear skirt facets continue the flank angles, drawn slanted cut restored
2026-11-10 WS-03 blueprint shell: 14 panels traced from sheet 71's flat patterns, faceted, scaled to the chassis, relieved for the swing sweep (first pass, silhouette IoU 0.45-0.58)
    [P1.stl, P10L.stl, P10R.stl, P11.stl, P2L.stl, P2R.stl, P3.stl, P4.stl]
2026-11-10 blueprint shell rev 2: rear lower as a front-to-back tunnel (single watertight shell), hood aligned to fenders/bumper, P8+P10 fused, P9 pitched down to P10, seamless roof frame joints
    [P10L.stl, P10R.stl, P11.stl, P3.stl, P4.stl, P5.stl, P8L.stl, P8P10L.stl]
2026-11-10 blueprint shell rev 3: roof frame legs under the skin, rear legs slot through tapered P9 cutouts, P4+P5 one frame with seamless creases
    [P4.stl, P4P5.stl, P5.stl, P9.stl]
2026-11-10 Revert "blueprint shell rev 3: roof frame legs under the skin, rear legs slot through tapered P9 cutouts, P4+P5 one frame with seamless creases"
    This reverts commit a343e37bc8a898ccc0ba87c7430cd0a278464fce.
    [P4.stl, P4P5.stl, P5.stl, P9.stl]
2026-11-10 blueprint shell: pillars blended onto the skin (flared feet cut by the skin plane), rev 3 reverted
    [P5.stl]
2026-11-10 blueprint shell: roof frame legs taper in plan and slot through cutouts in the rear upper cover
    [P5.stl, P9.stl]
